Catalysxt/fir3fly/README.md

# fir3fly
This is an enlarged 4-digit 7-segment display. The motivation is to track my boxing sessions.

- [Interactive HTML BOM](https://Catalysxt.github.io/fir3fly/ibom_v2.html)
