Catalysxt/fir3fly/docs/7-seg display.png

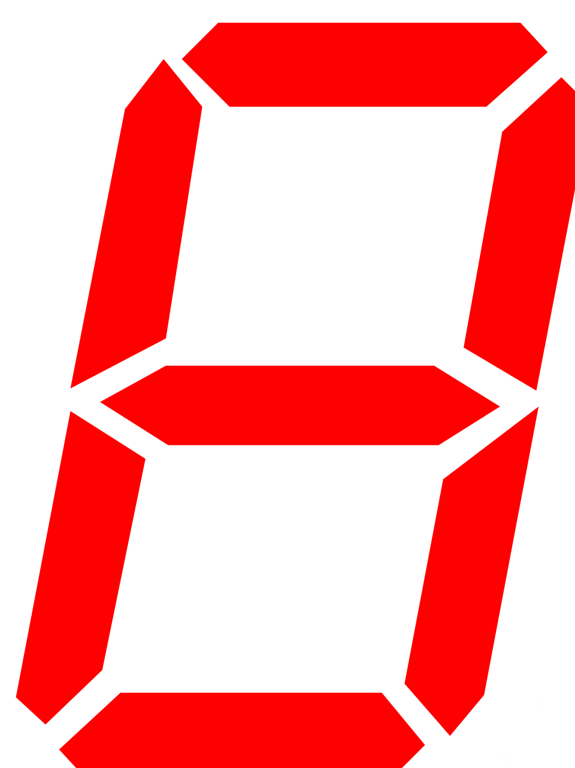
docs/7-seg display.png
