Catalysxt/fir3fly/fab/current/3d_img_1.png

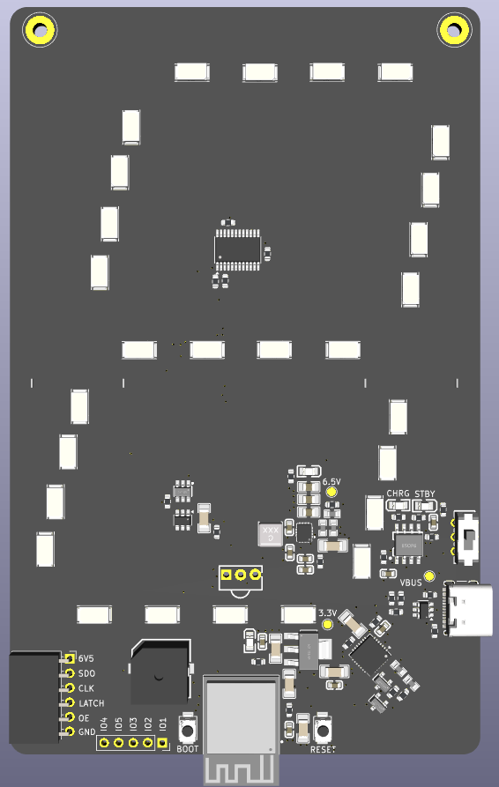
fab/current/3d_img_1.png
