Catalysxt/fir3fly/fab/current/3d_img_2.png

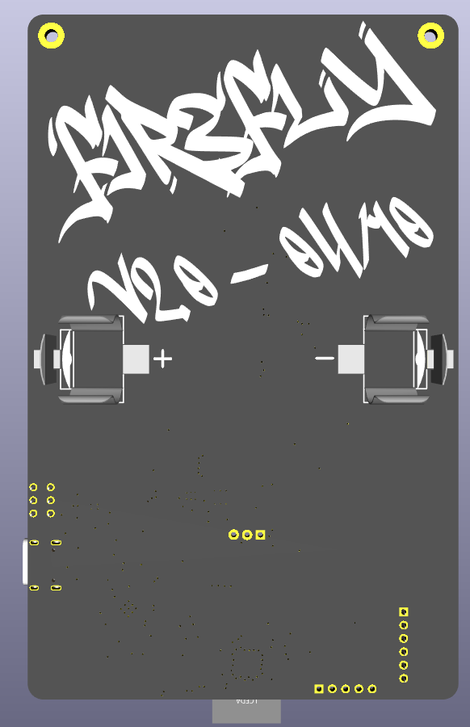
fab/current/3d_img_2.png
