Catalysxt/fir3fly/fab/current/fab_layer_plots_v2_images/B.Silk.png

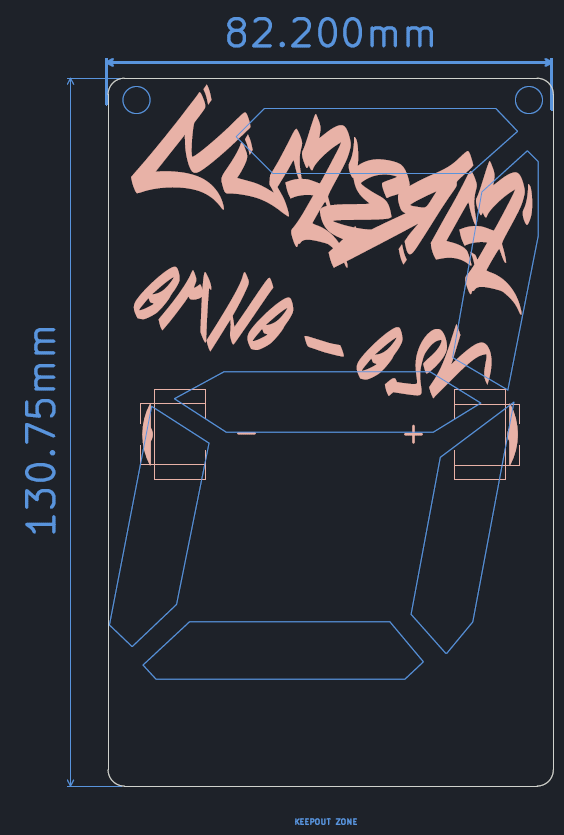
fab/current/fab_layer_plots_v2_images/B.Silk.png
