Catalysxt/fir3fly/fab/current/fab_layer_plots_v2_images/F.Cu.png

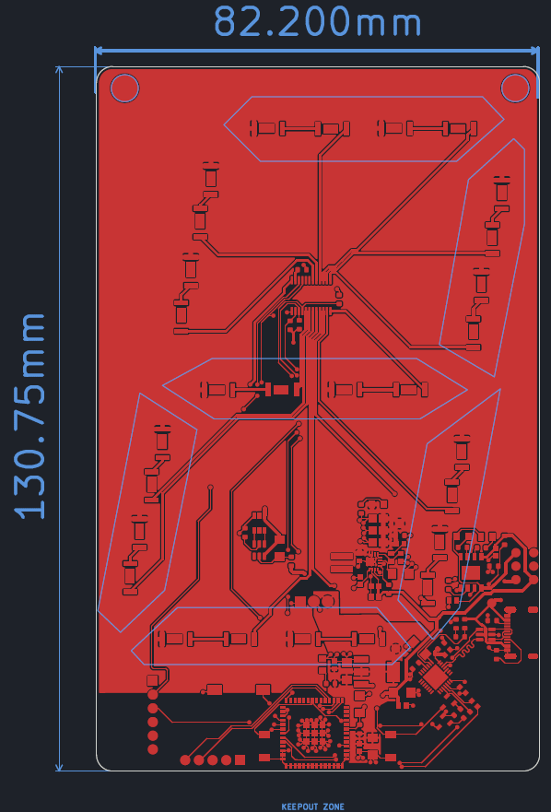
fab/current/fab_layer_plots_v2_images/F.Cu.png
