Catalysxt/fir3fly/fab/current/fab_layer_plots_v2_images/F.Silk.png

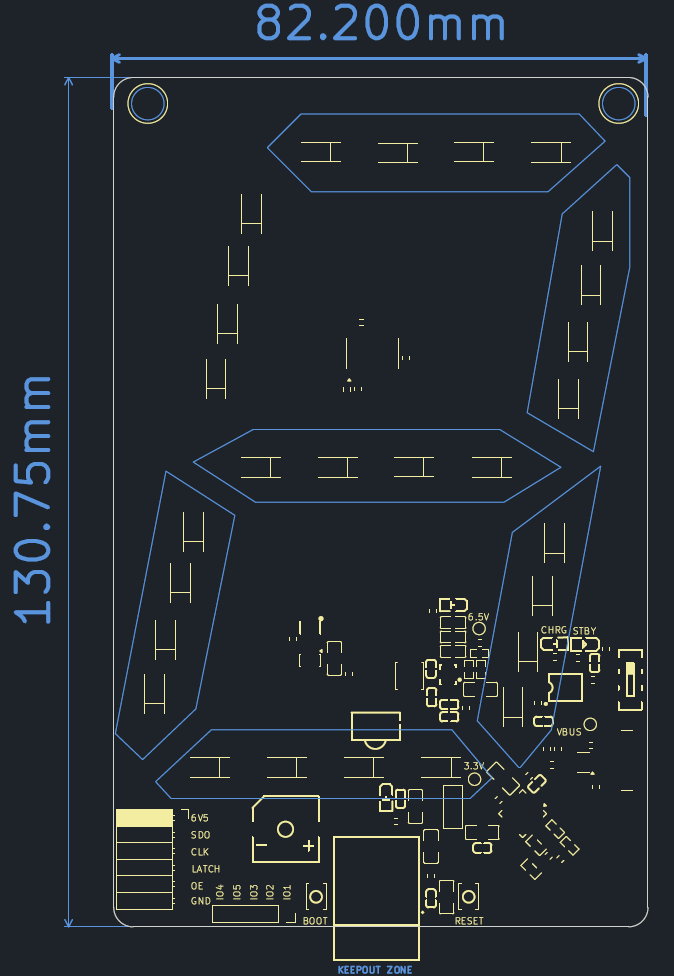
fab/current/fab_layer_plots_v2_images/F.Silk.png
