Catalysxt/fir3fly/fab/current/sch_v1_images/1.png

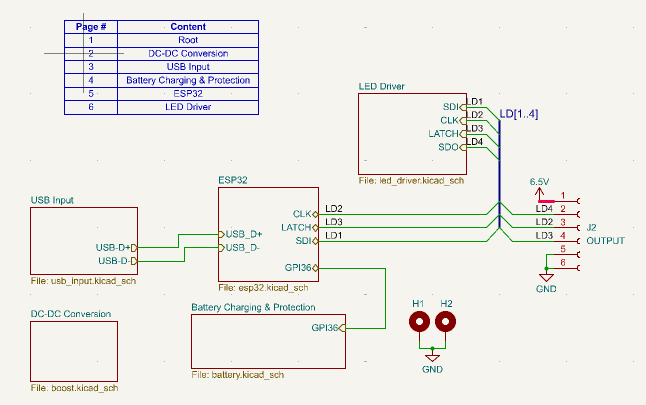
fab/current/sch_v1_images/1.png
