Catalysxt/fir3fly/fab/current/sch_v1_images/3.png

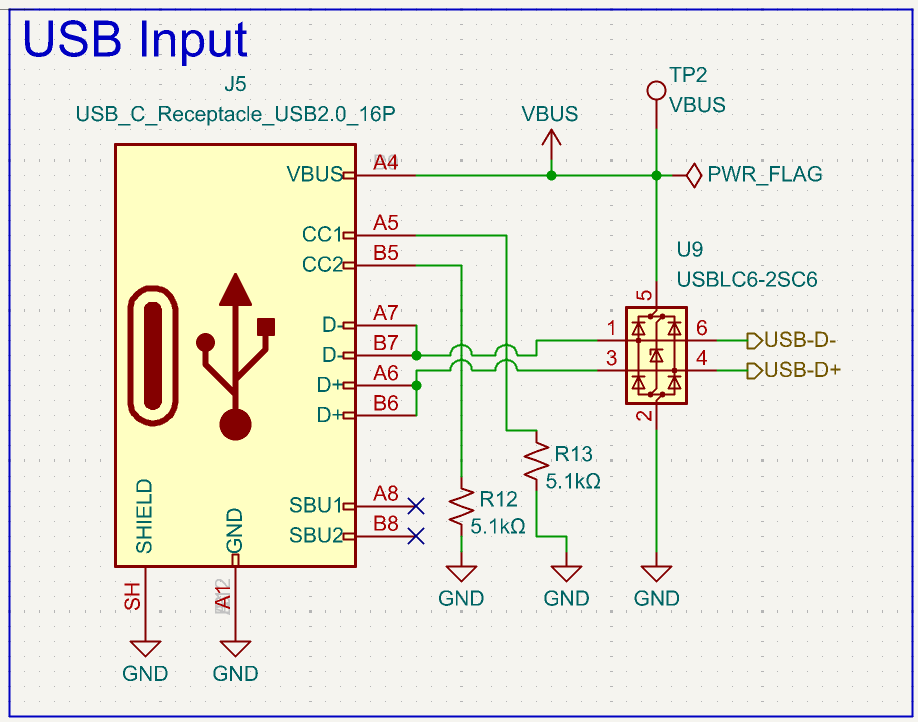
fab/current/sch_v1_images/3.png
