Catalysxt/fir3fly/fab/current/sch_v1_images/4.png

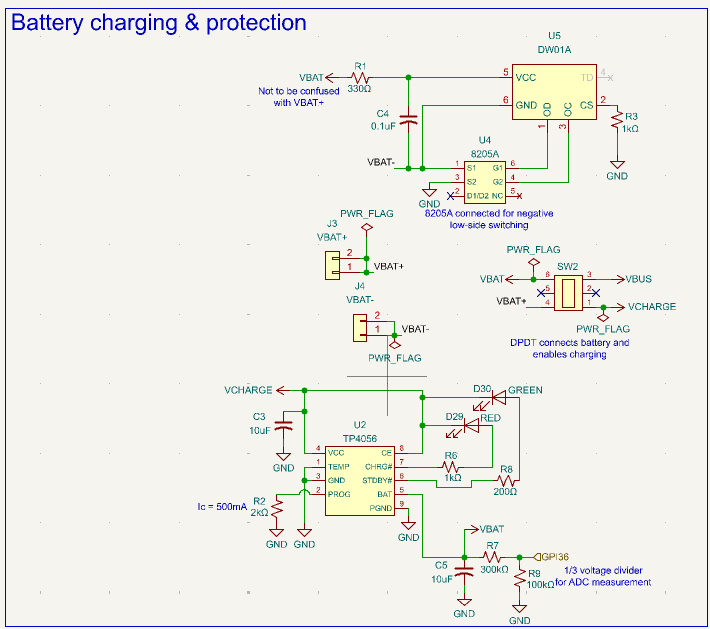
fab/current/sch_v1_images/4.png
