Catalysxt/fir3fly/fab/current/sch_v1_images/5.png

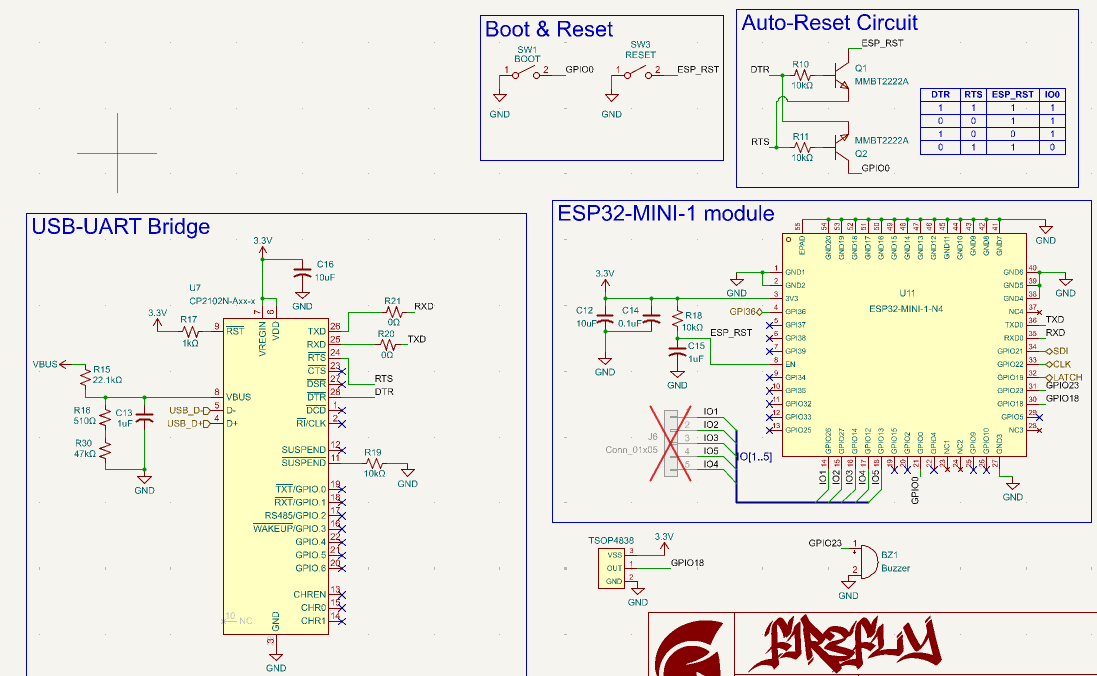
fab/current/sch_v1_images/5.png
