Catalysxt/fir3fly/fab/current/sch_v1_images/6.png

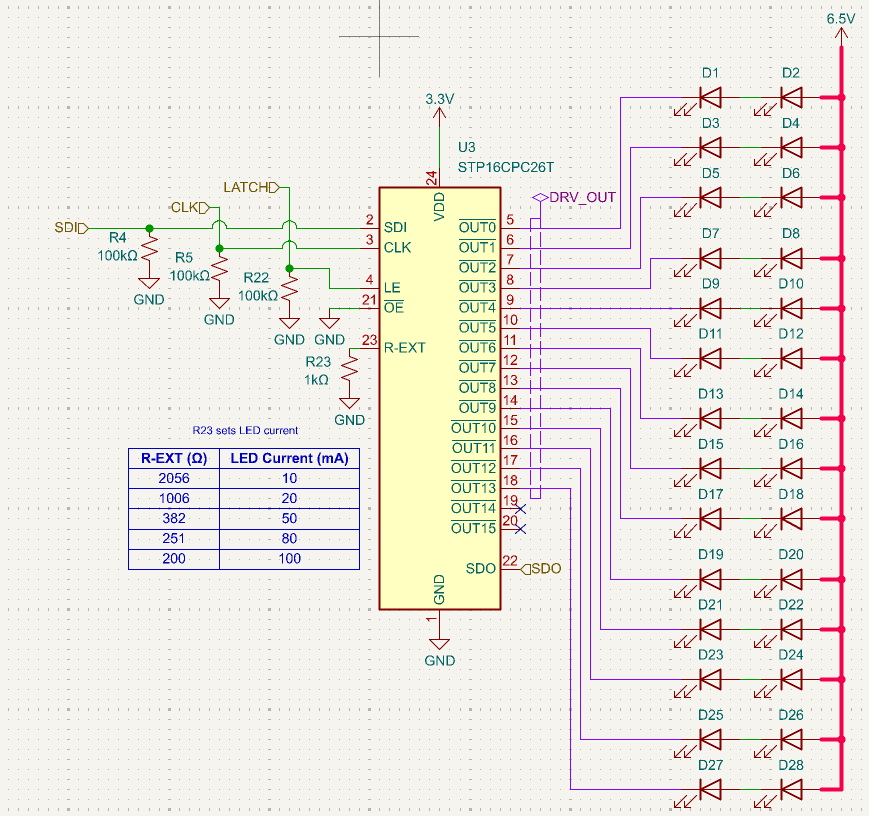
fab/current/sch_v1_images/6.png
