Catalysxt/fir3fly/docs/enclosure/3d_model.step

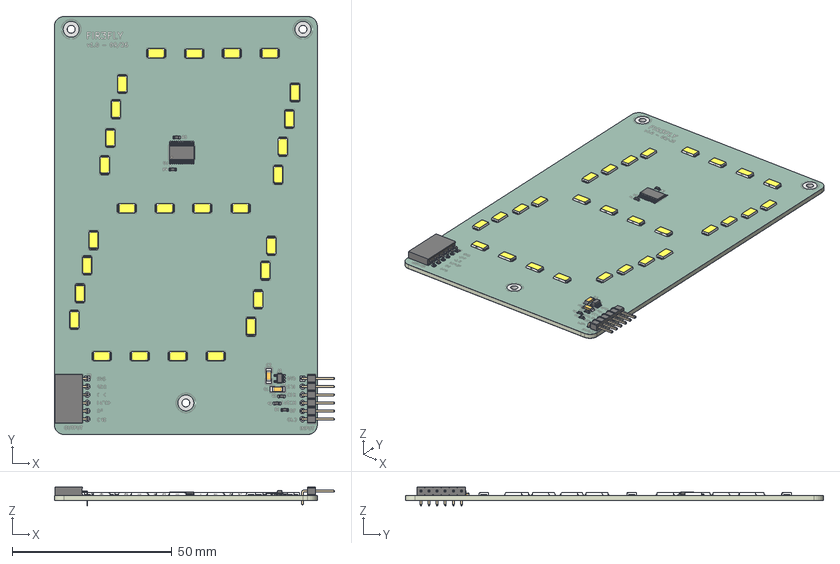
[picture p15: CAD file, 2026-10-04]
docs/enclosure/3d_model.step
87.7 x 130.8 x 5.84 mm
R_0603_1608Metric x 5
C1206_L3.2-W1.6-H1.3 x 2
LED-SMD_3P-L5.7-W3.0-H0.8 x 28
SOT-23-5
PinHeader_1x06_P254mm_Horizontal
PinSocket_1x06_P2.54mm_Horizontal
TSSOP-24_4.4x7.8mm_P0.65mm
fir3fly_one_side_copper
fir3fly_one_side_pad
fir3fly_one_side_via
fir3fly_one_side_silkscreen
fir3fly_one_side_soldermask x 2
fir3fly_one_side_PCB
