Catalysxt/fir3fly/docs/enclosure/Enclosure_Base.stl

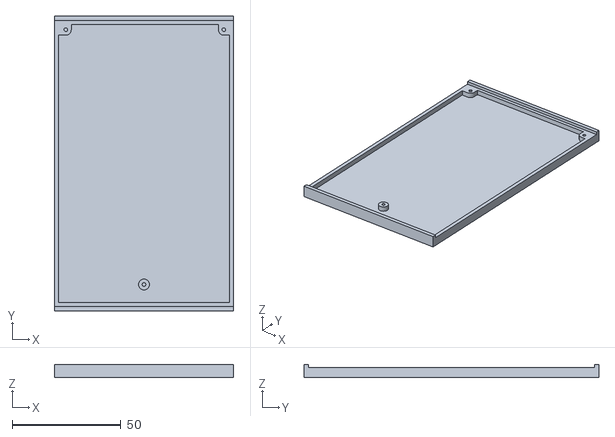
[picture p16: CAD file, 2026-10-04]
docs/enclosure/Enclosure_Base.stl
82.2 x 135.3 x 6.00
