Catalysxt/fir3fly/docs/enclosure/Enclosure_Lid.stl

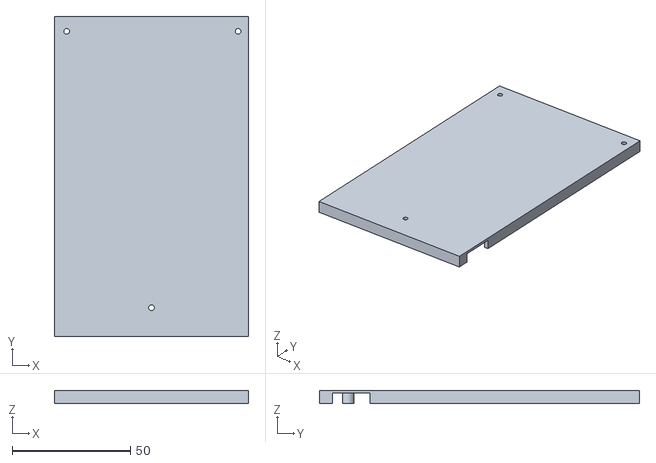
[picture p17: CAD file, 2026-10-04]
docs/enclosure/Enclosure_Lid.stl
82.2 x 135.3 x 5.70
