Catalysxt/fir3fly/docs/enclosure/enclosure.FCStd

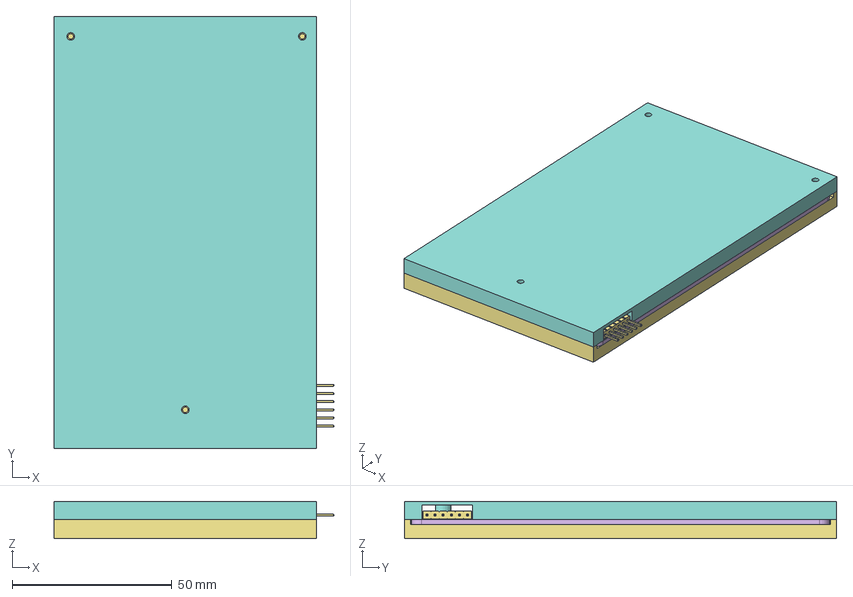
[picture p18: CAD file, 2026-10-04]
docs/enclosure/enclosure.FCStd
87.7 x 135.4 x 11.7 mm
R_0603_1608Metric
C1206_L3.2-W1.6-H1.3
LED-SMD_3P-L5.7-W3.0-H0.8
LED-SMD_3P-L5.7-W3.0-H0.009
LED-SMD_3P-L5.7-W3.0-H0.010
LED-SMD_3P-L5.7-W3.0-H0.011
C1206_L3.2-W1.6-H1.004
SOT-23-5
R_0603_1608Metric002
LED-SMD_3P-L5.7-W3.0-H0.012
LED-SMD_3P-L5.7-W3.0-H0.013
LED-SMD_3P-L5.7-W3.0-H0.014
LED-SMD_3P-L5.7-W3.0-H0.015
R_0603_1608Metric004
PinHeader_1x06_P254mm_Horizontal
LED-SMD_3P-L5.7-W3.0-H0.016
LED-SMD_3P-L5.7-W3.0-H0.017
LED-SMD_3P-L5.7-W3.0-H0.018
LED-SMD_3P-L5.7-W3.0-H0.019
PinSocket_1x06_P2.54mm_Horizontal
LED-SMD_3P-L5.7-W3.0-H0.020
R_0603_1608Metric006
LED-SMD_3P-L5.7-W3.0-H0.021
LED-SMD_3P-L5.7-W3.0-H0.022
LED-SMD_3P-L5.7-W3.0-H0.023
LED-SMD_3P-L5.7-W3.0-H0.024
LED-SMD_3P-L5.7-W3.0-H0.025
LED-SMD_3P-L5.7-W3.0-H0.026
LED-SMD_3P-L5.7-W3.0-H0.027
LED-SMD_3P-L5.7-W3.0-H0.028
LED-SMD_3P-L5.7-W3.0-H0.029
TSSOP-24_4.4x7.8mm_P0.65mm
LED-SMD_3P-L5.7-W3.0-H0.030
LED-SMD_3P-L5.7-W3.0-H0.031
LED-SMD_3P-L5.7-W3.0-H0.032
R_0603_1608Metric008
LED-SMD_3P-L5.7-W3.0-H0.033
LED-SMD_3P-L5.7-W3.0-H0.034
LED-SMD_3P-L5.7-W3.0-H0.035
fir3fly_one_side_copper
fir3fly_one_side_pad
fir3fly_one_side_via
fir3fly_one_side_silkscreen
fir3fly_one_side_soldermask
fir3fly_one_side_soldermask001
fir3fly_one_side_PCB
Enclosure_Base
Enclosure_Lid
