Catalysxt/fir3fly/docs/schematic_v2.pdf

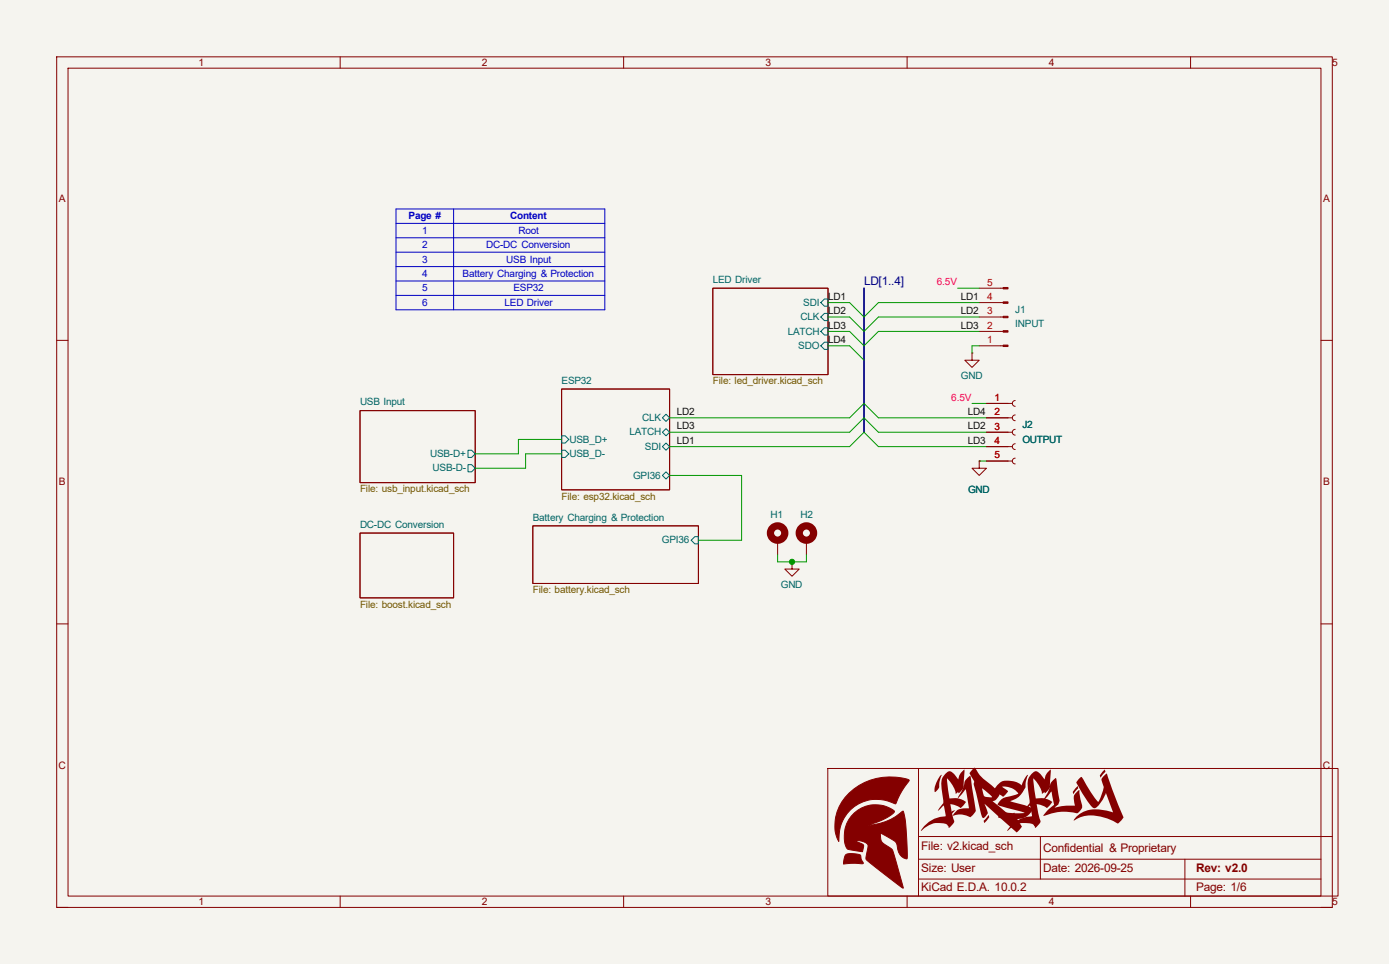
[picture p19: page 1]

3 | Battery Charging & Protection USB Input 4

5 | ESP32

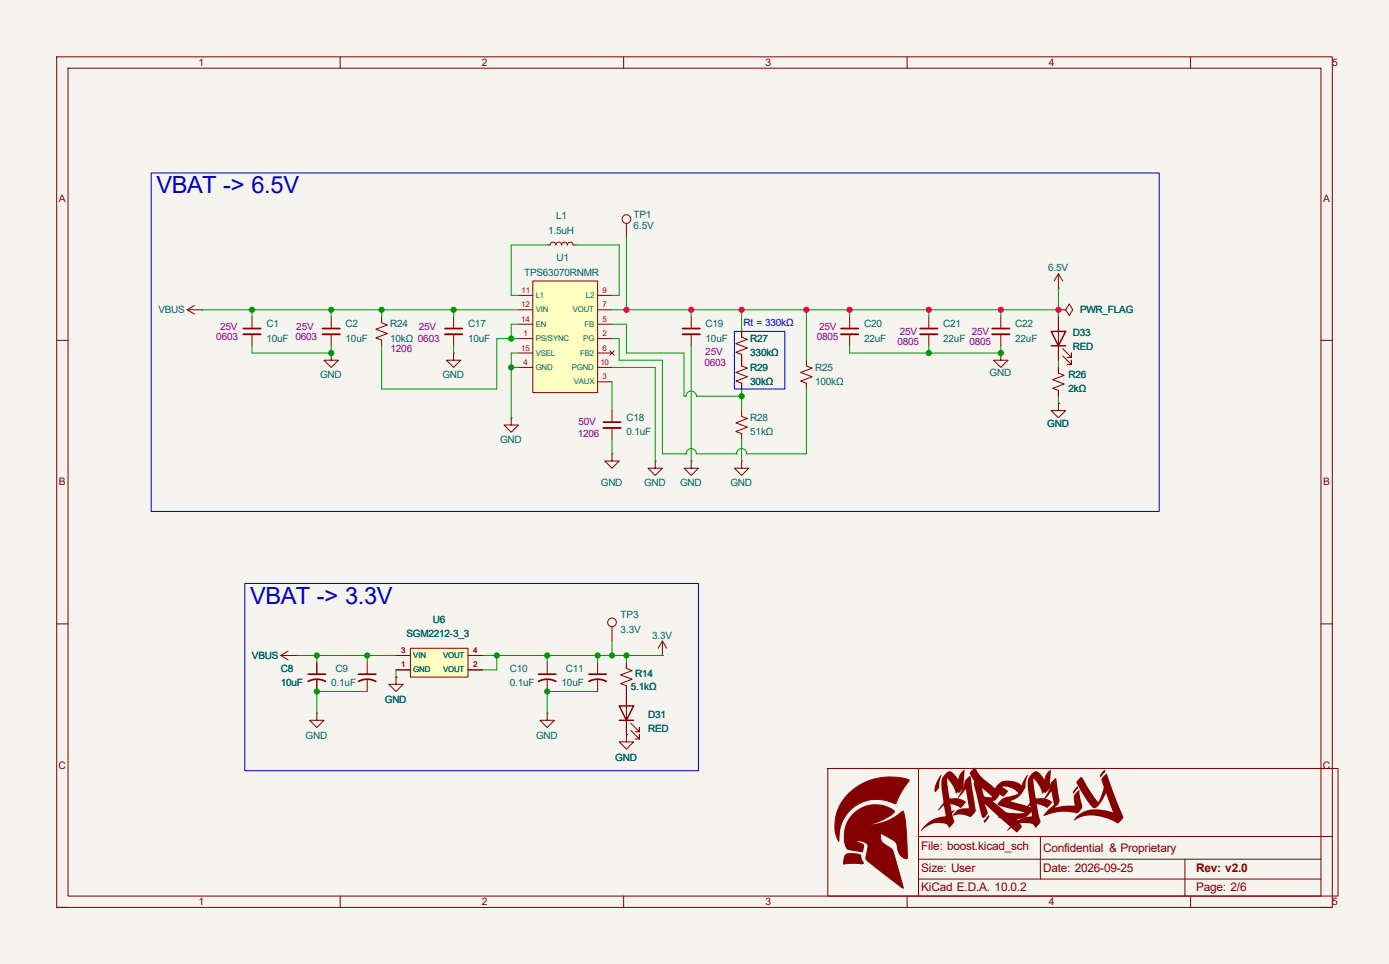
[picture p20: page 2]

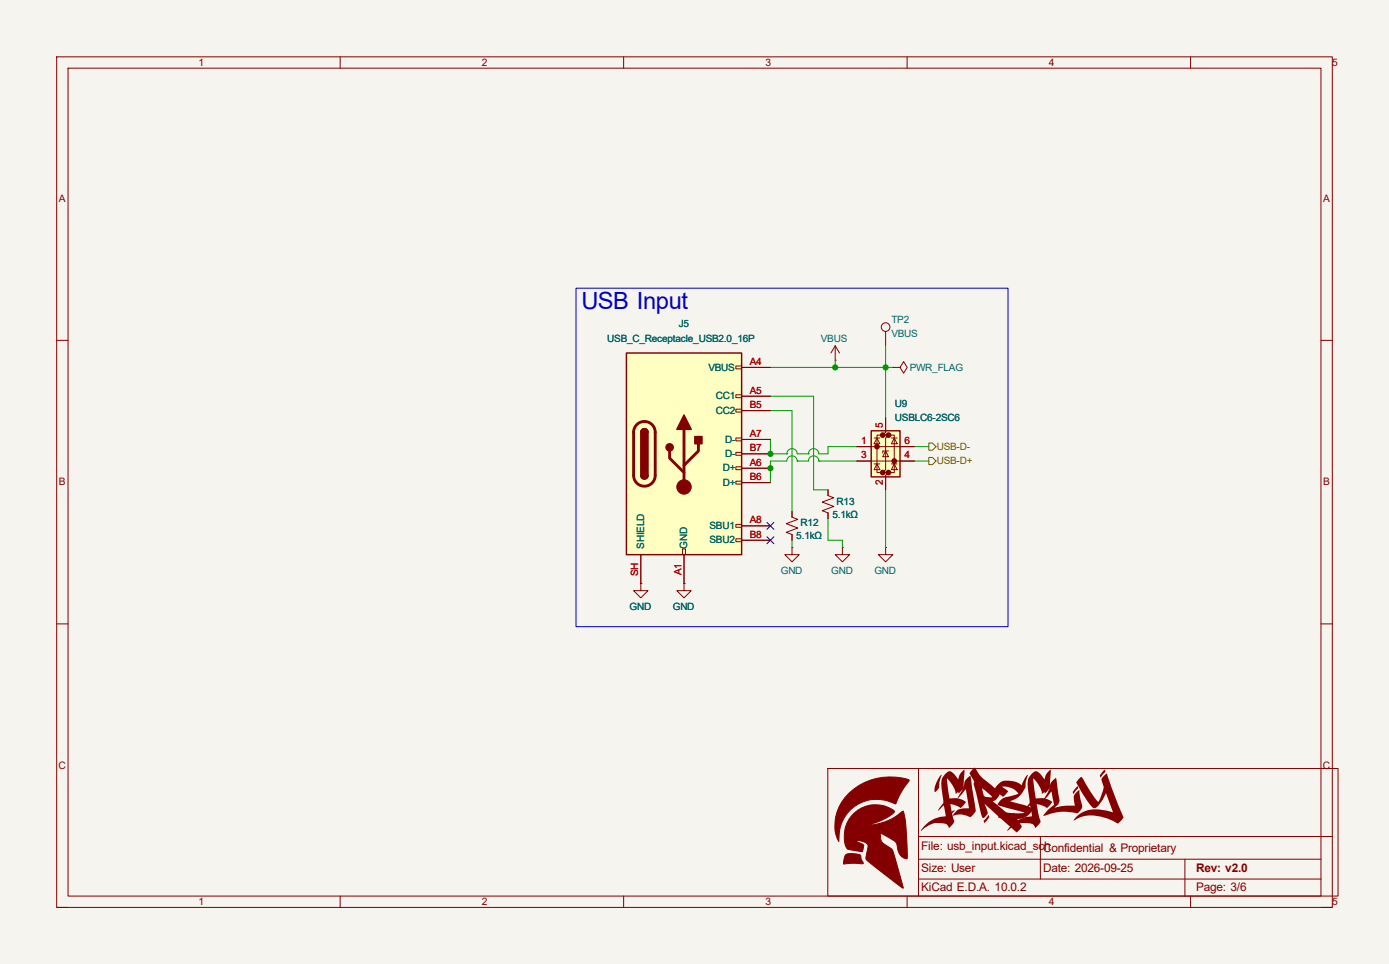
[picture p21: page 3]

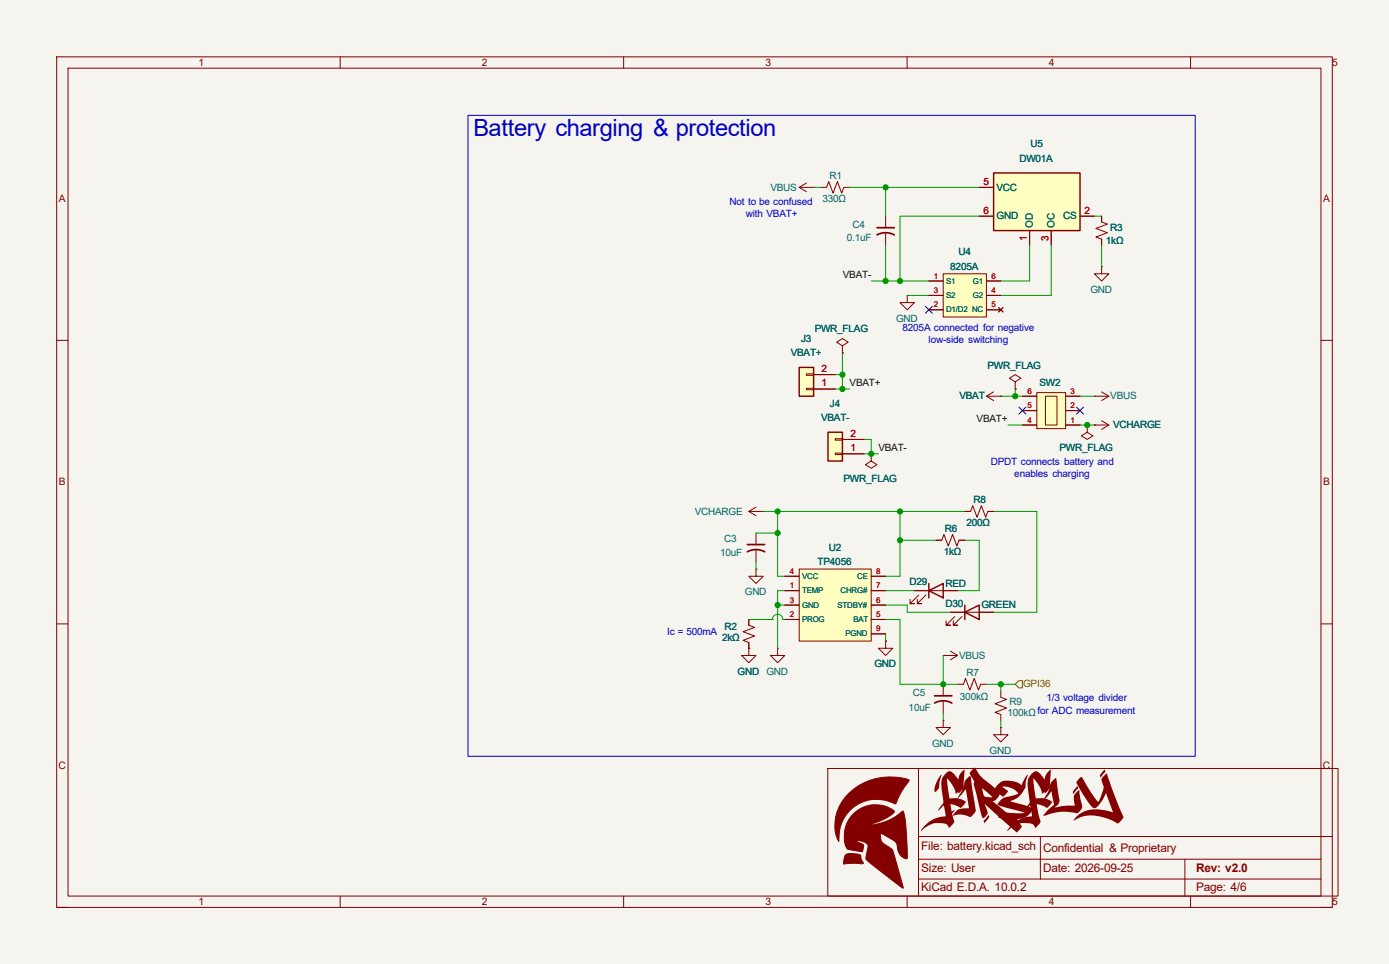
[picture p22: page 4]

VBUS GPI36 VBAT+ VBAT- VBAT- VBAT+ Battery charging & protection
VBATR8

PWR_FLAG 12
low-side switching VBAT PWR_FLAG

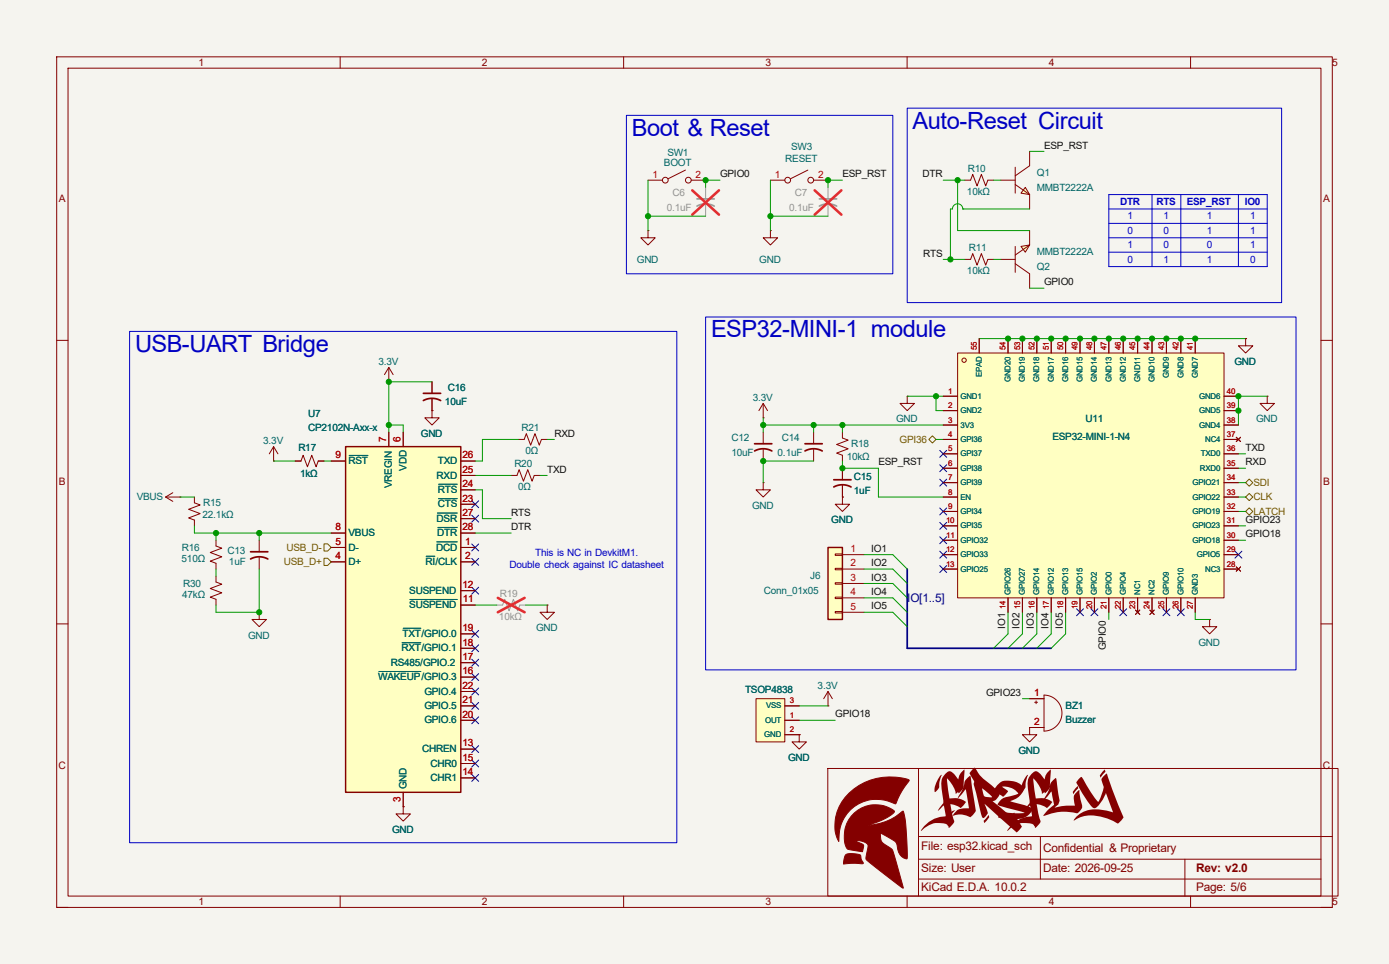
[picture p23: page 5]

Auto-Reset Circuit

ESP32-MINI-1 module USB-UART Bridge

7 VBUS 8 RST 9 SUSPEND 11 SUSPEND 12 CHREN 13 CHR1 14 CHR0 15 WAKEUP/GPIO.3 16 RS485/GPIO.2 17 RXT/GPIO.1 18 TXT/GPIO.0 19 GPIO.6 20 GPIO.5 21 GPIO.4 22 CTS 23 RTS 24 RXD 25 TXD 26 DSR 27 DTR 28 U7CP2102N-Axx-x R19

7 VBUS 8 RST 9 SUSPEND 11 SUSPEND 12 CHREN 13 CHR1 14 CHR0 15 WAKEUP/GPIO.3 16 RS485/GPIO.2 17 RXT/GPIO.1 18 TXT/GPIO.0 19 GPIO.6 20 GPIO.5 21 GPIO.4 22 CTS 23 RTS 24 RXD 25 TXD 26 DSR 27 DTR 28 GND

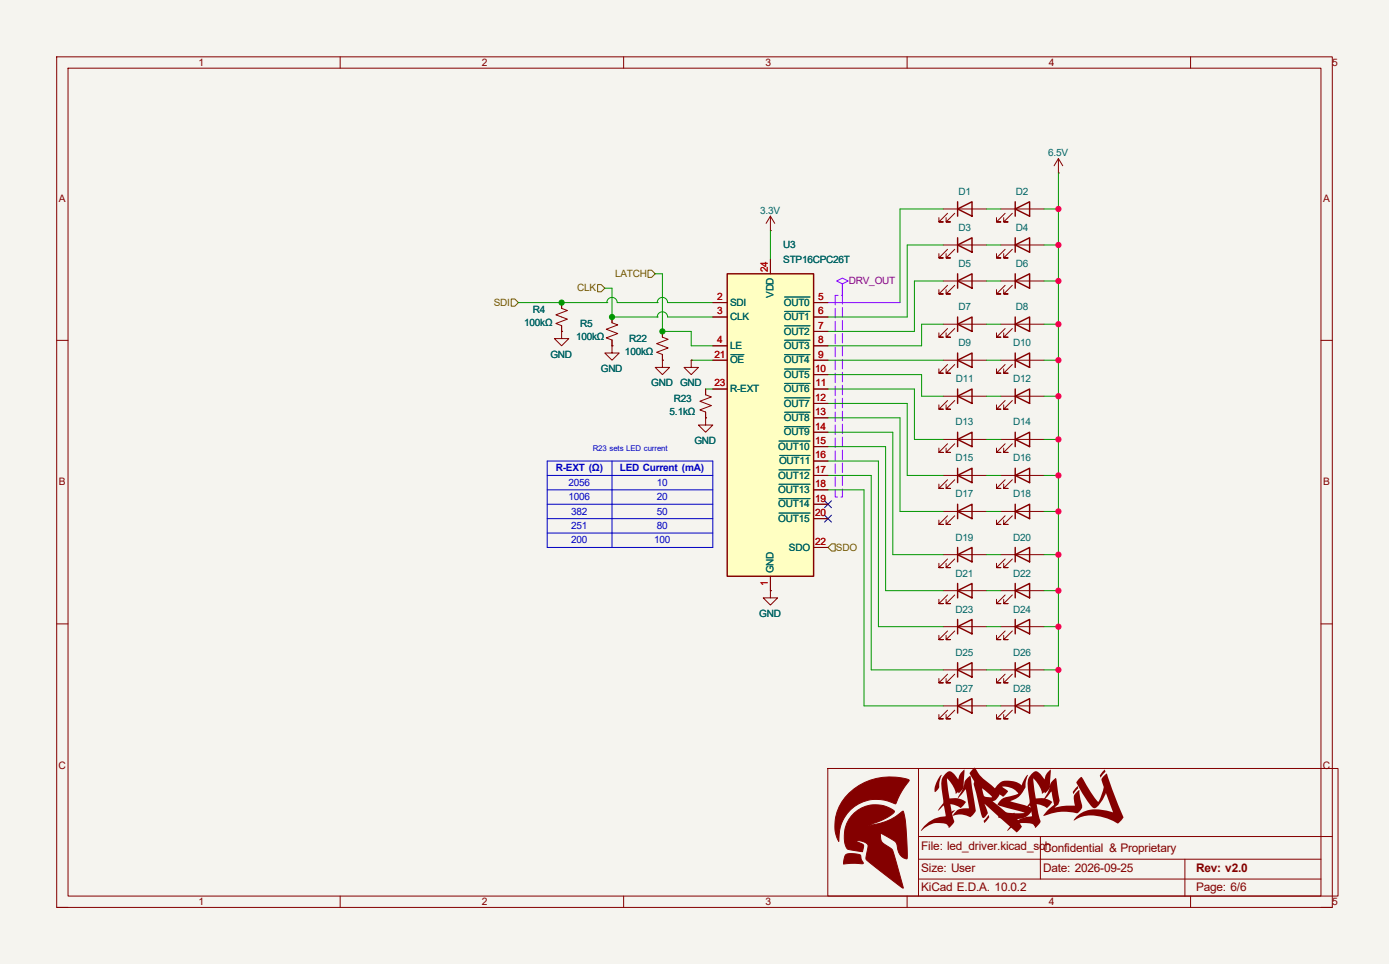
[picture p24: page 6]

R-EXT (Ω) | LED Current (mA) 2056 10

1006 | 20
382 | 50
251 | 80
