Catalysxt/fir3fly/fab/current/fabrication_layer_plots_v2.pdf

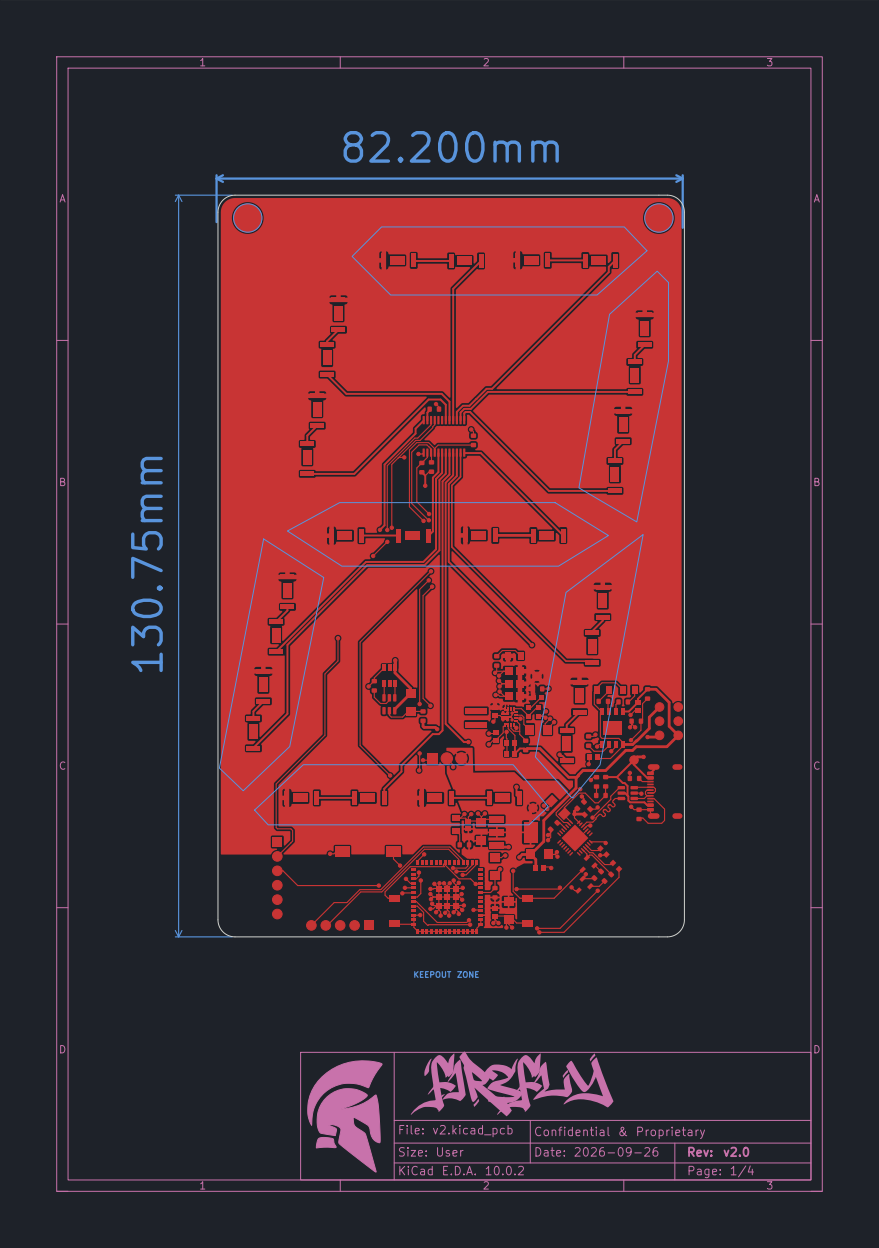
[picture p25: page 1]

FIR3FLY | D Date: 2026-09-26

File: v2.kicad_pcb | Confidential & Proprietary
Size: User | | Rev: v2.0
KiCad E.D.A. 10.0.2

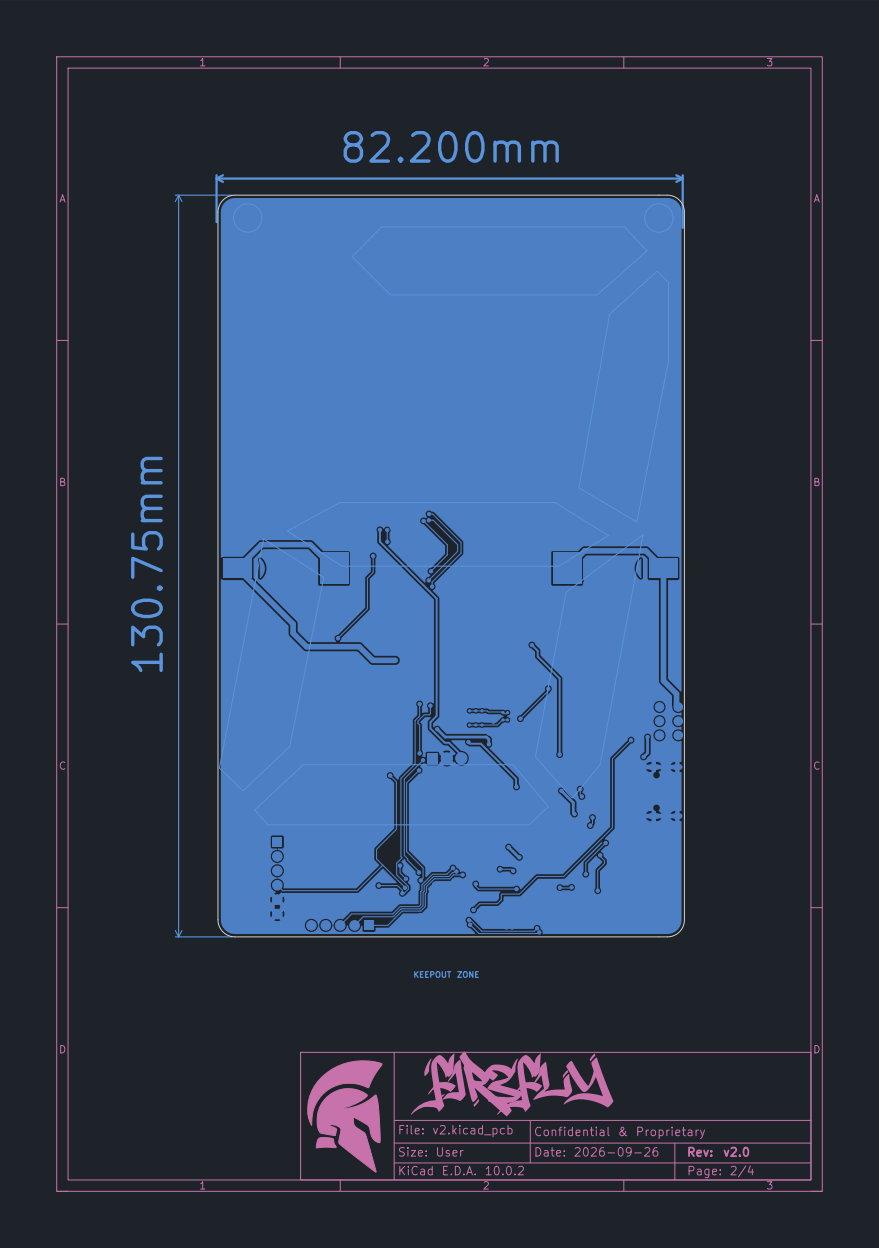
[picture p26: page 2]

FIR3FLY | D Date: 2026-09-26

File: v2.kicad_pcb | Confidential & Proprietary

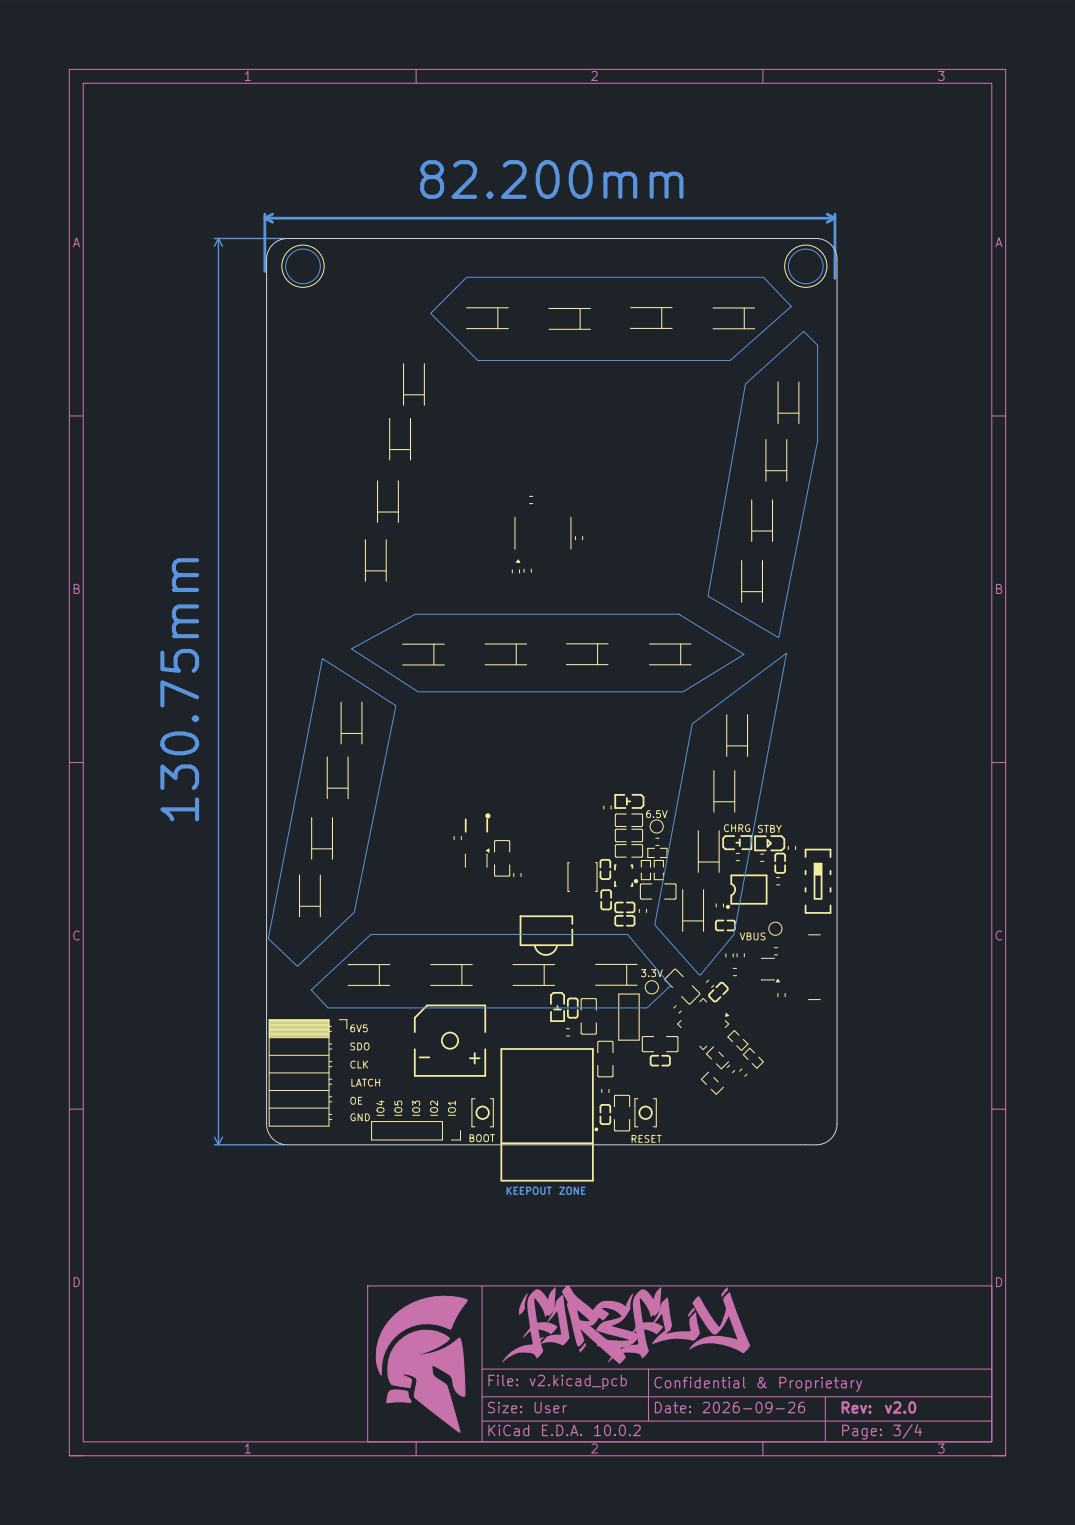
[picture p27: page 3]

FIR3FLY | D Date: 2026-09-26

File: v2.kicad_pcb | Confidential & Proprietary

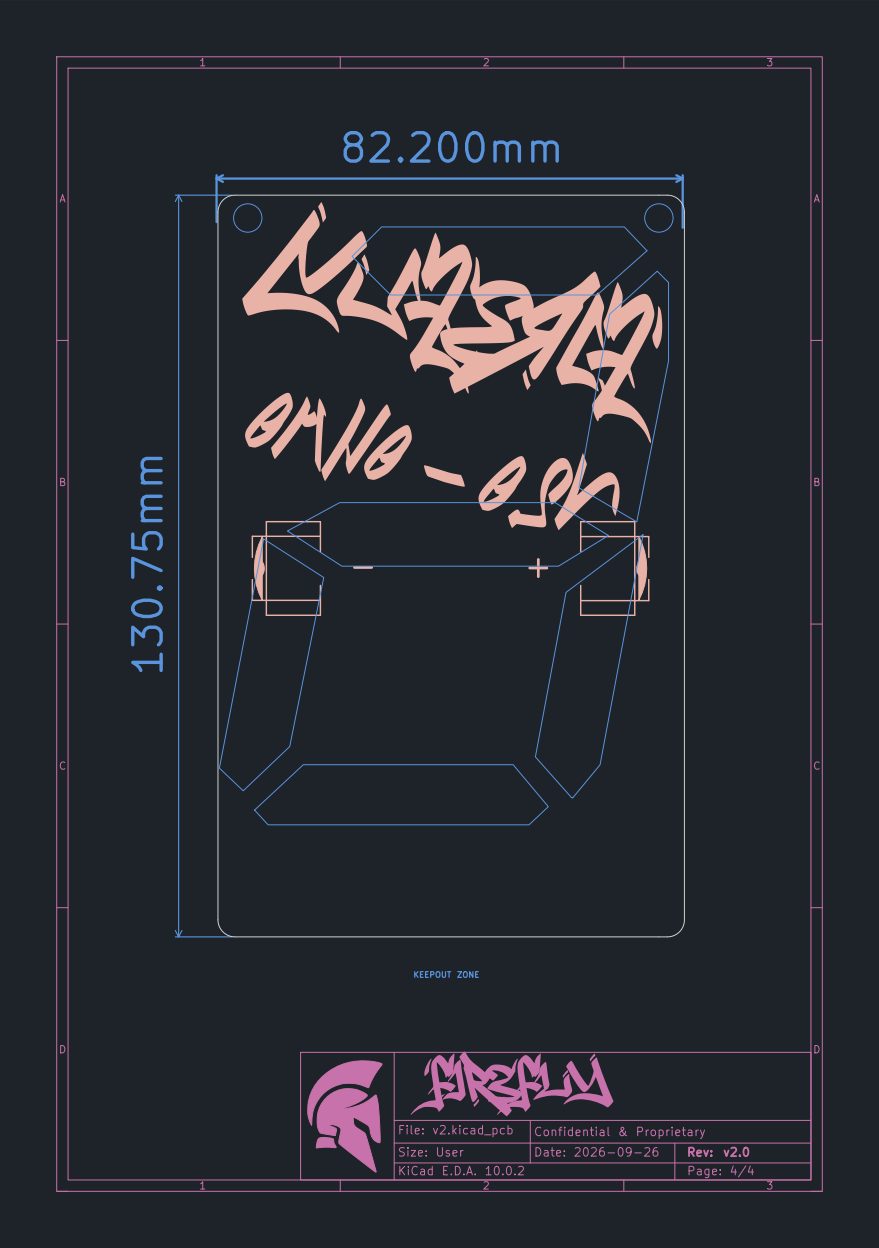
[picture p28: page 4]

FIR3FLY | D Date: 2026-09-26

File: v2.kicad_pcb | Confidential & Proprietary
