Catalysxt/fir3fly/fab/current/schematic_v2.pdf

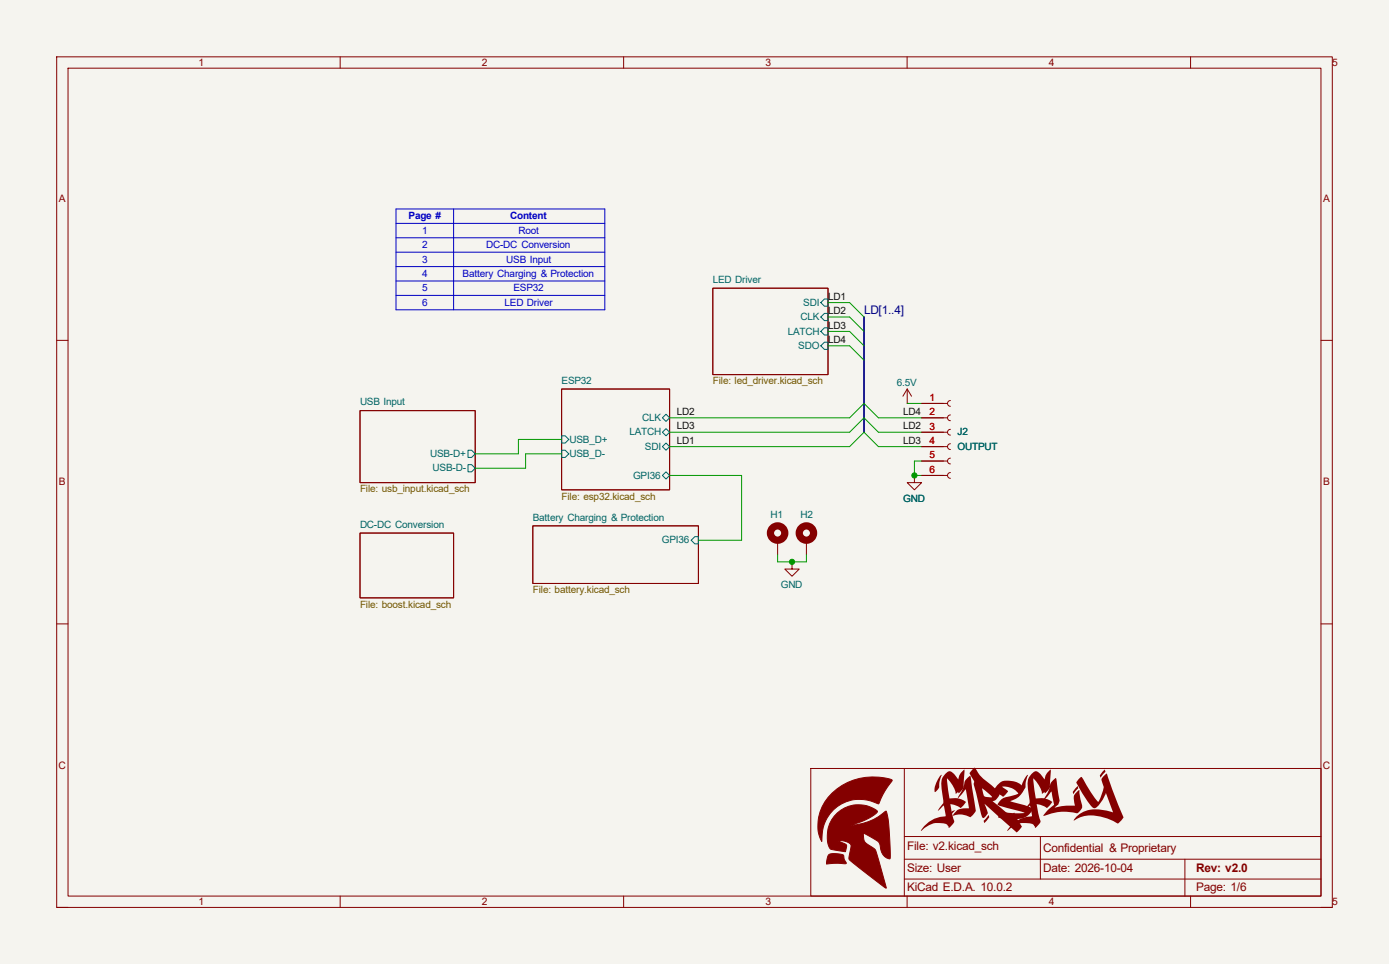
[picture p29: page 1]

LED Driver File: led_driver.kicad_sch GND

3 | Battery Charging & Protection USB Input 4

5 | ESP32

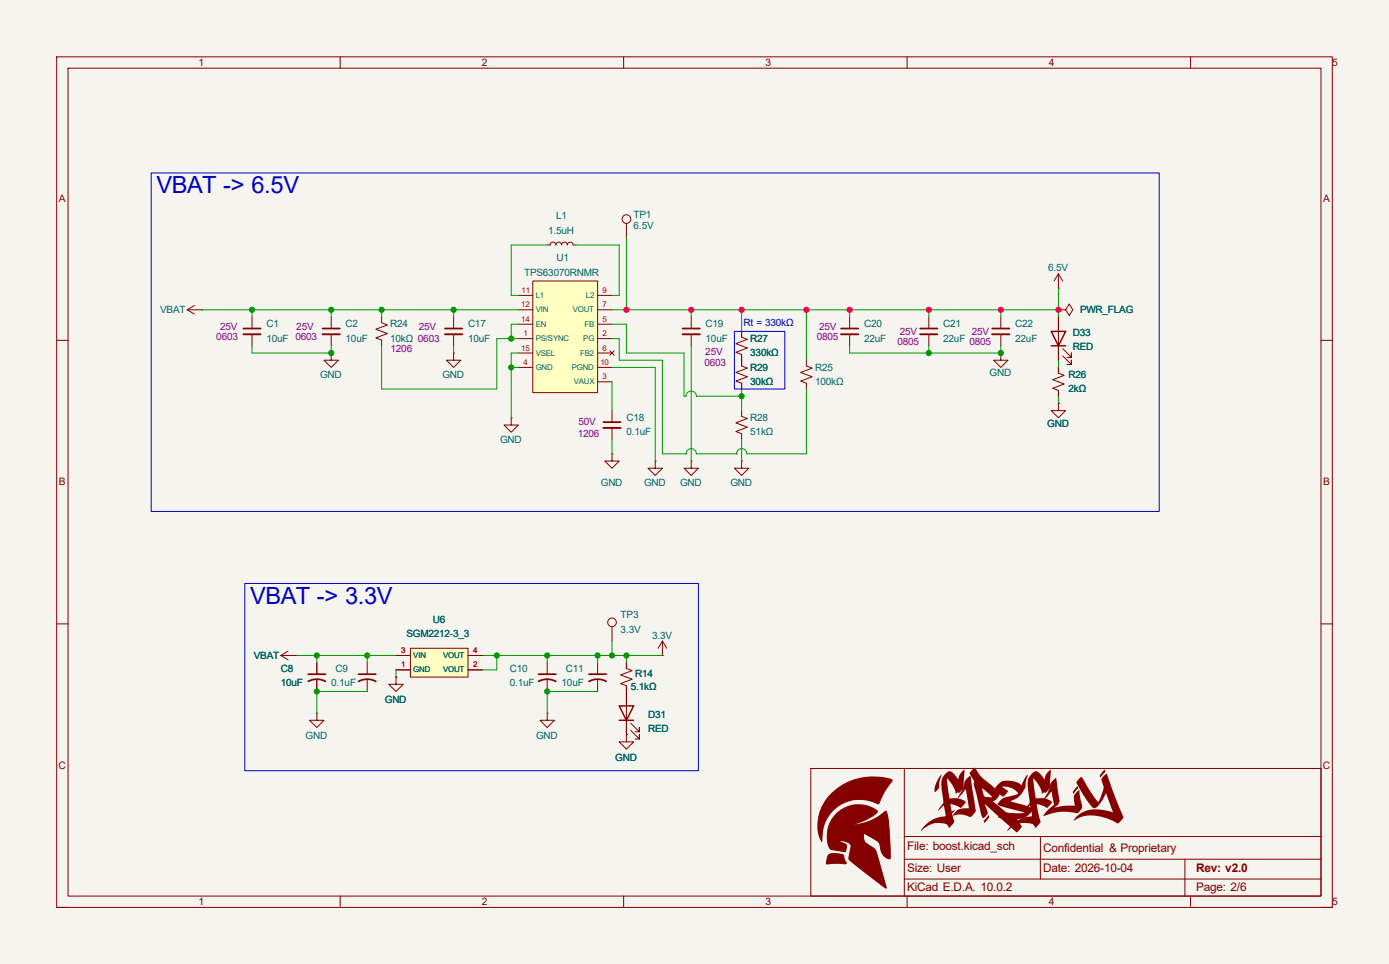
[picture p30: page 2]

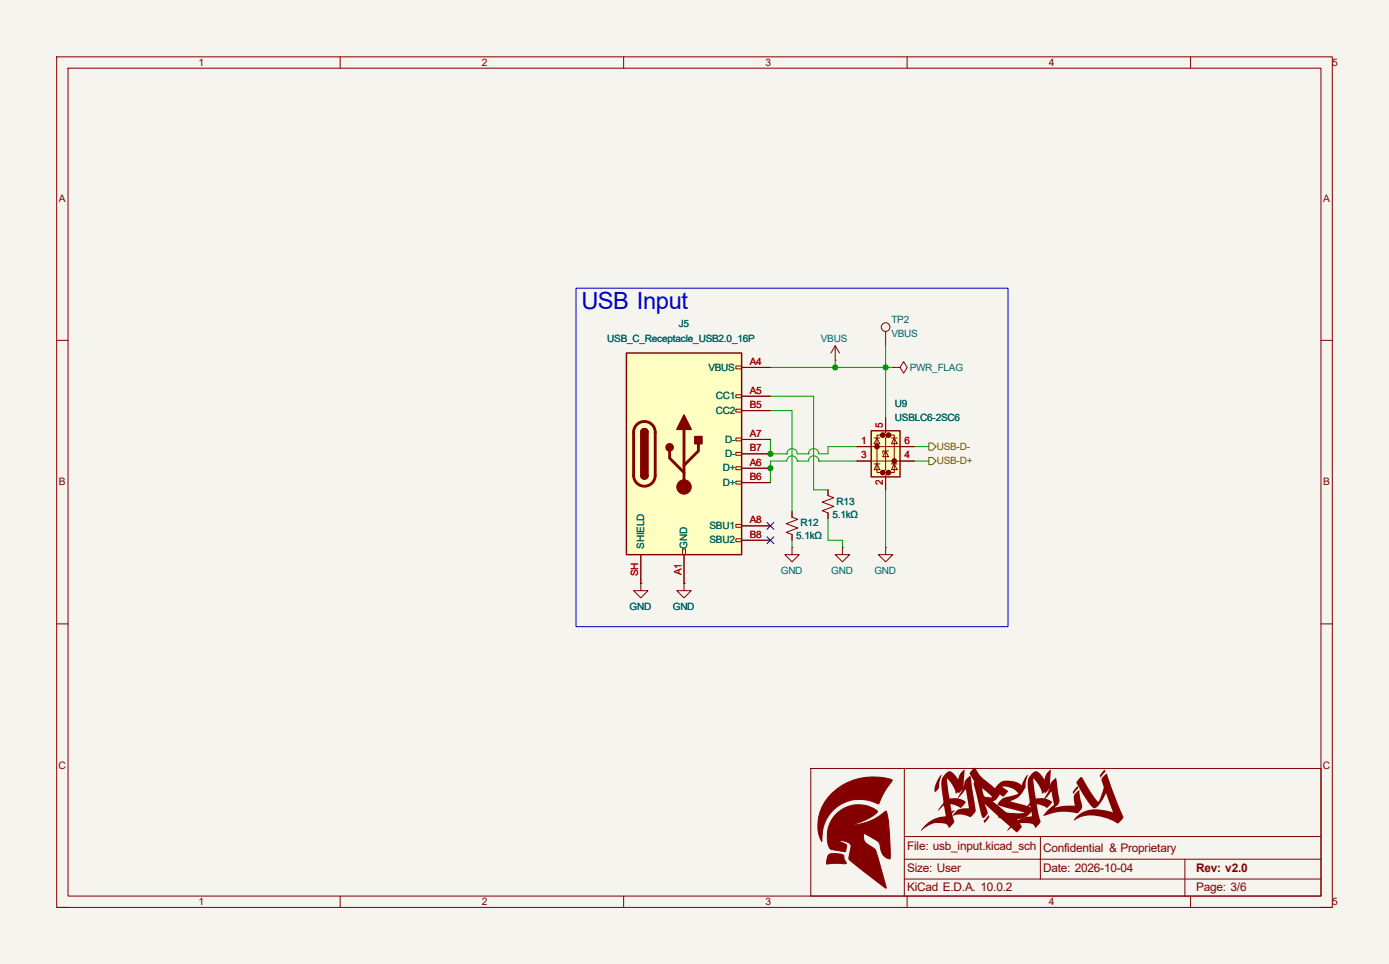
[picture p31: page 3]

USB-D+ USB-D- USB Input

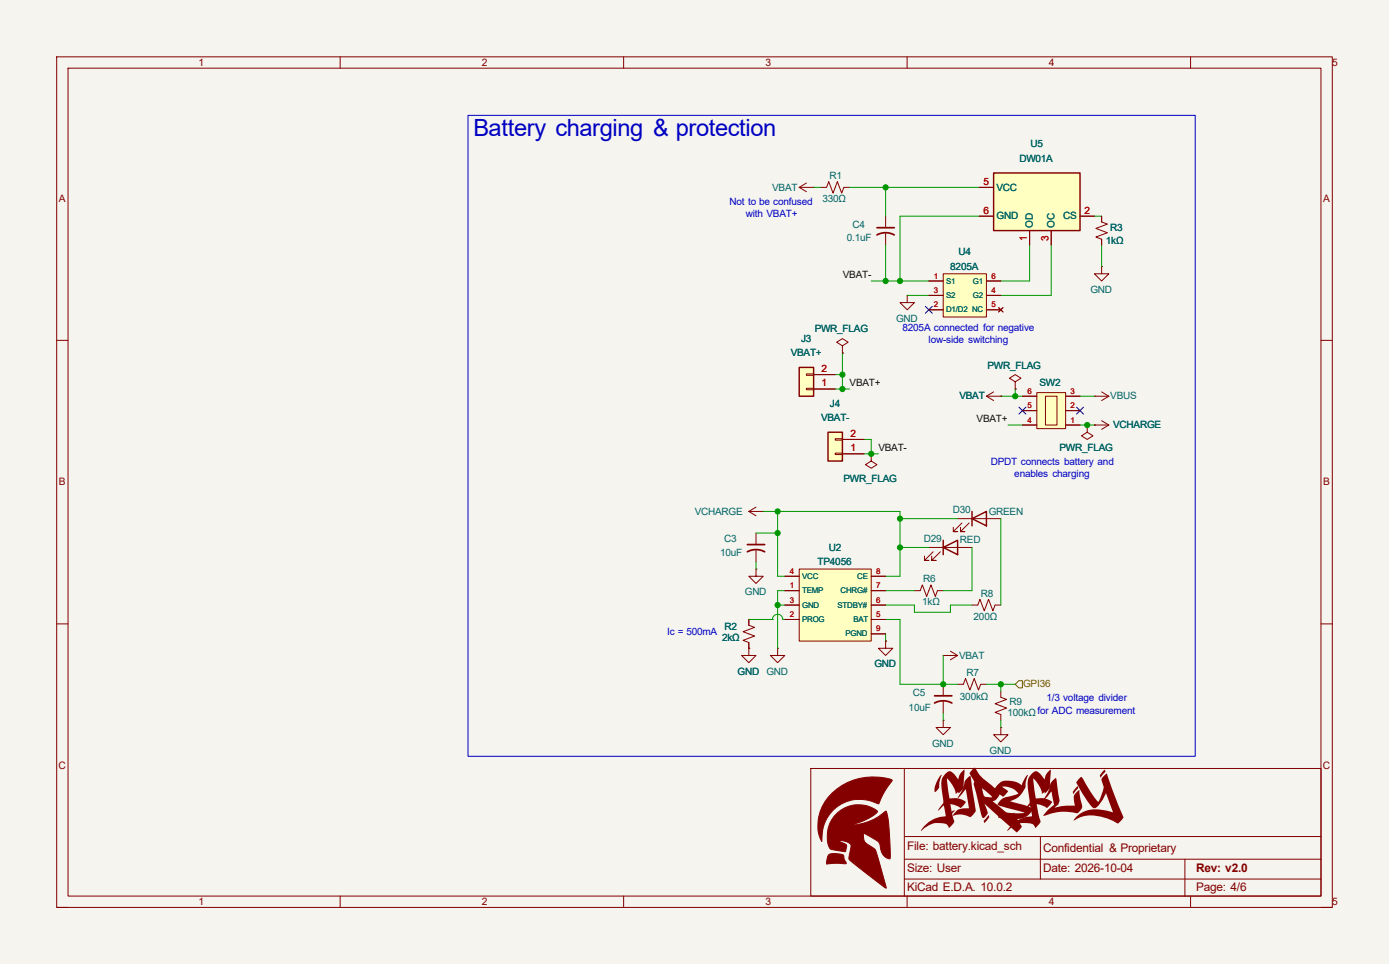
[picture p32: page 4]

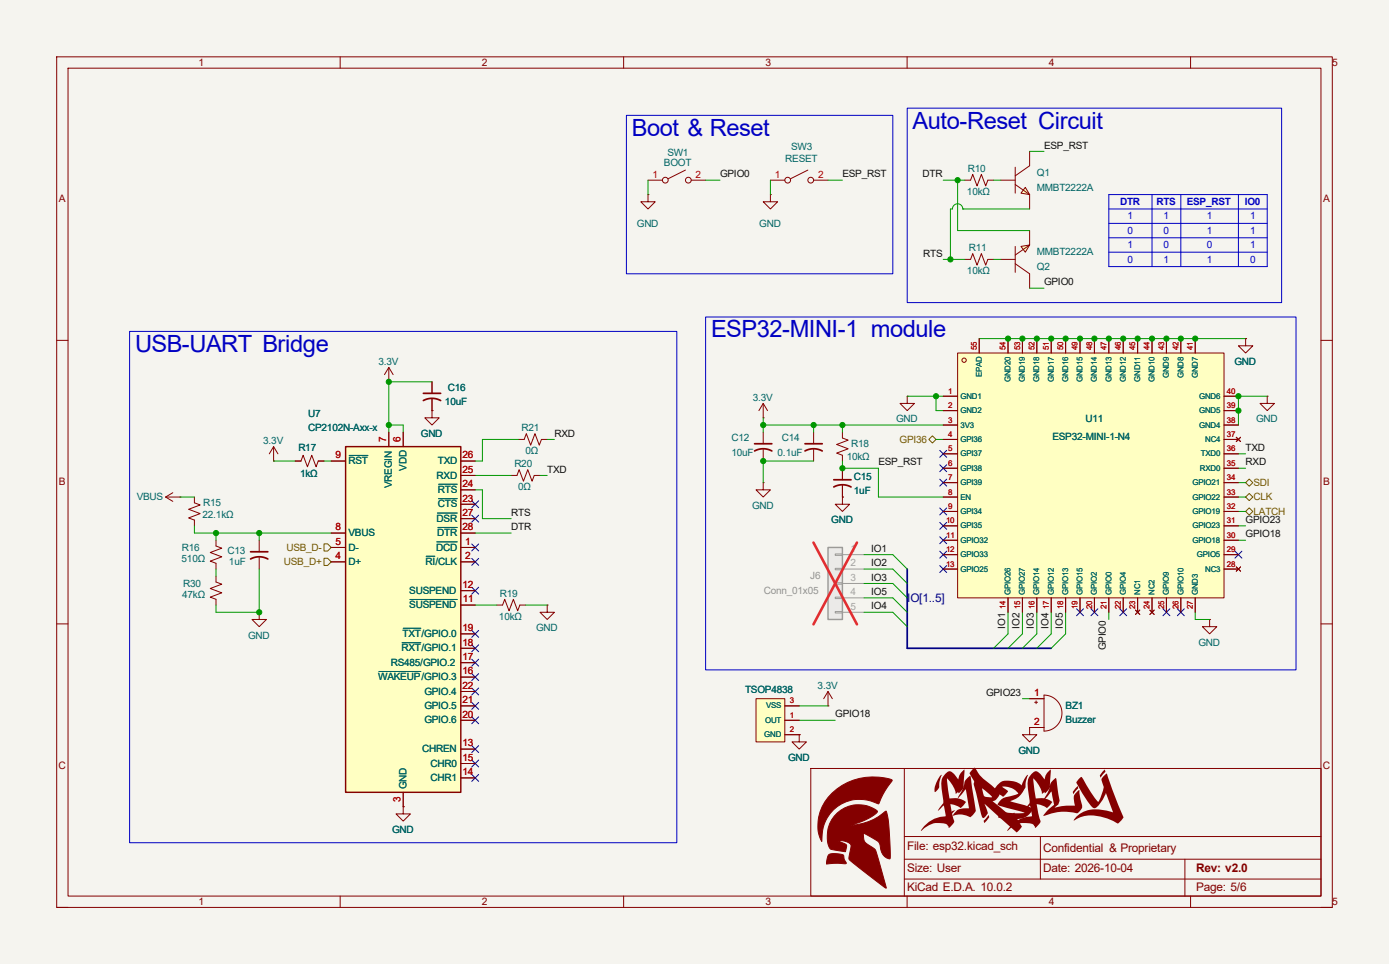
[picture p33: page 5]

DTR | RTS | ESP_RST | IO0

7 VBUS 8 RST 9 SUSPEND 11 SUSPEND 12 CHREN 13 CHR1 14 CHR0 15 WAKEUP/GPIO.3 16 RS485/GPIO.2 17 RXT/GPIO.1 18 TXT/GPIO.0 19 GPIO.6 20 GPIO.5 21 GPIO.4 22 CTS 23 RTS 24 RXD 25 TXD 26 DSR 27 DTR 28 U7CP2102N-Axx-x R18

7 VBUS 8 RST 9 SUSPEND 11 SUSPEND 12 CHREN 13 CHR1 14 CHR0 15 WAKEUP/GPIO.3 16 RS485/GPIO.2 17 RXT/GPIO.1 18 TXT/GPIO.0 19 GPIO.6 20 GPIO.5 21 GPIO.4 22 CTS 23 RTS 24 RXD 25 TXD 26 DSR 27 DTR 28 R17

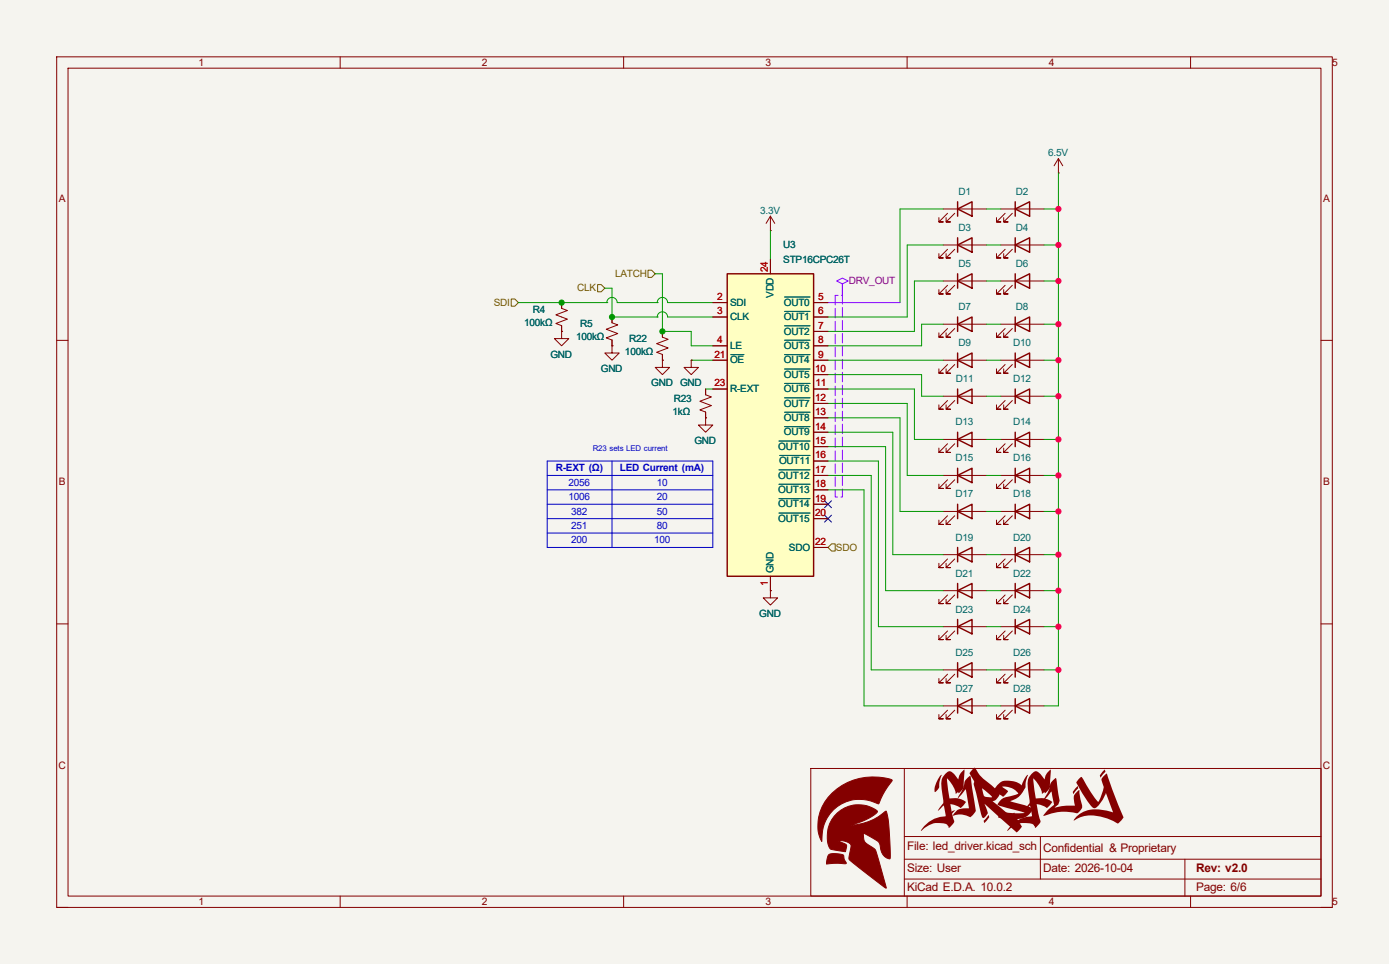
[picture p34: page 6]

1006 | 20
382 | 50
251 | 80
