Catalysxt/fir3fly/fab/archive/v1/fabrication layer plots.pdf

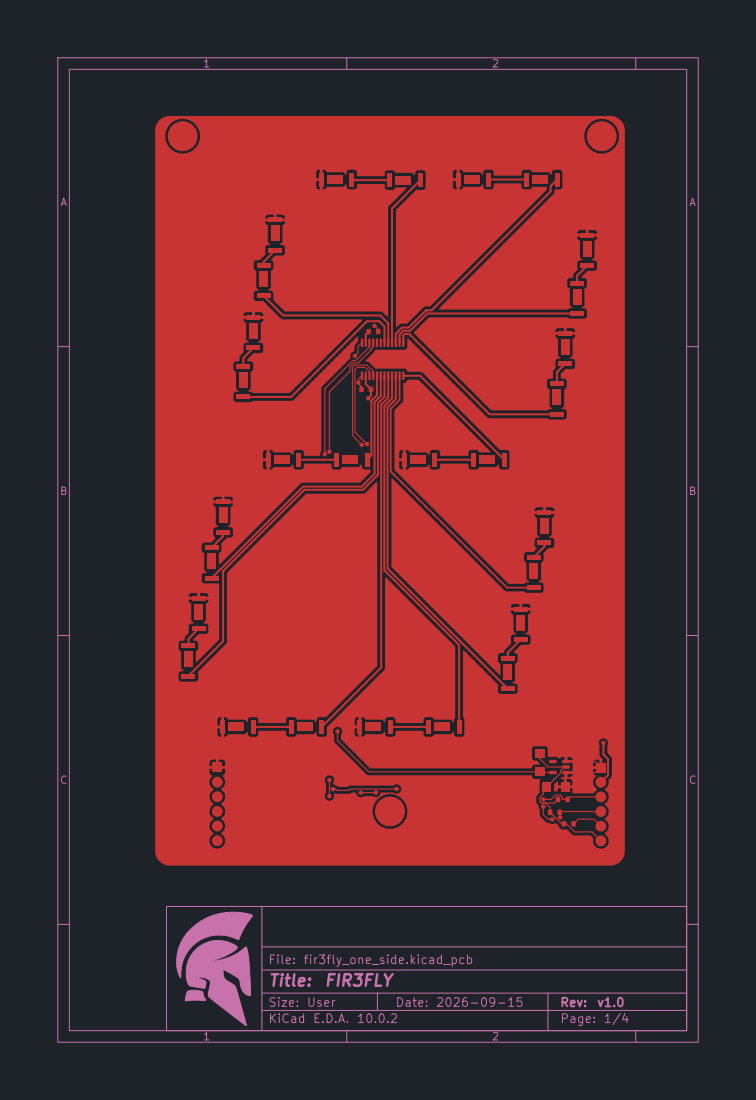
[picture p35: page 1]

Size: User | Rev: v1.0
KiCad E.D.A. 10.0.2

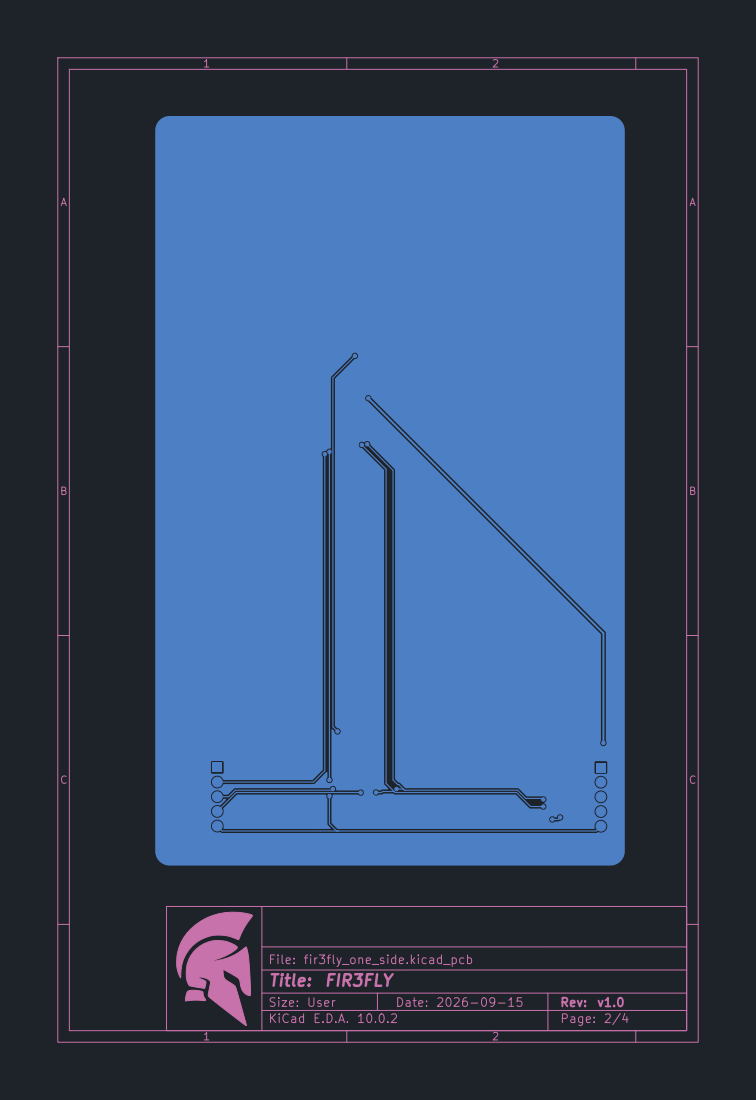
[picture p36: page 2]

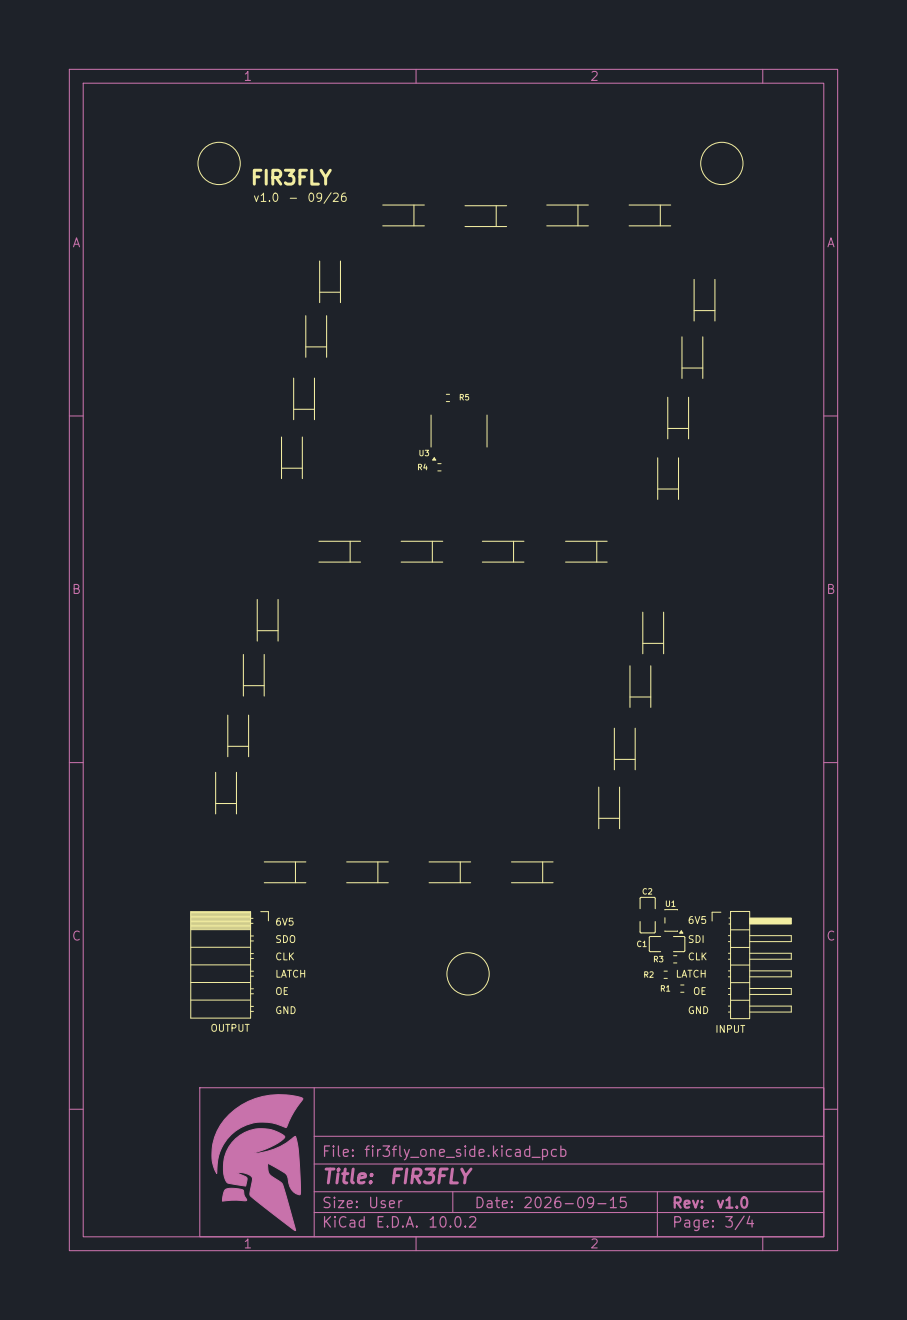
[picture p37: page 3]

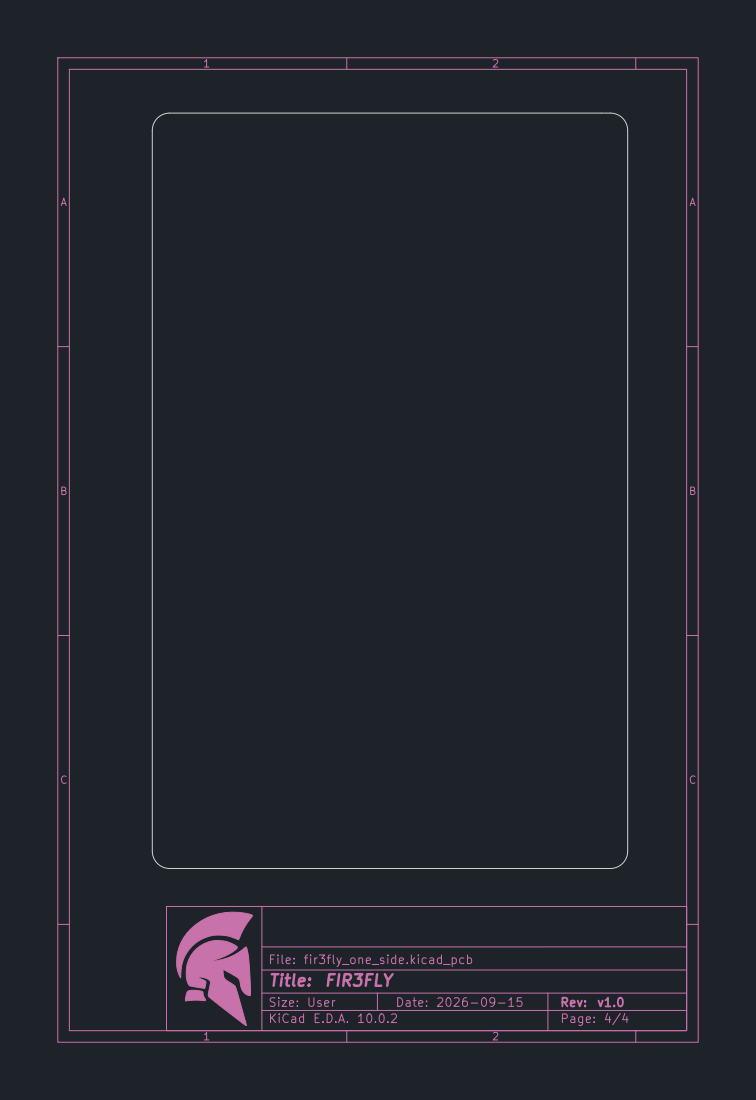
[picture p38: page 4]
