Catalysxt/fir3fly/fab/archive/v1/schematic_v1.1.pdf

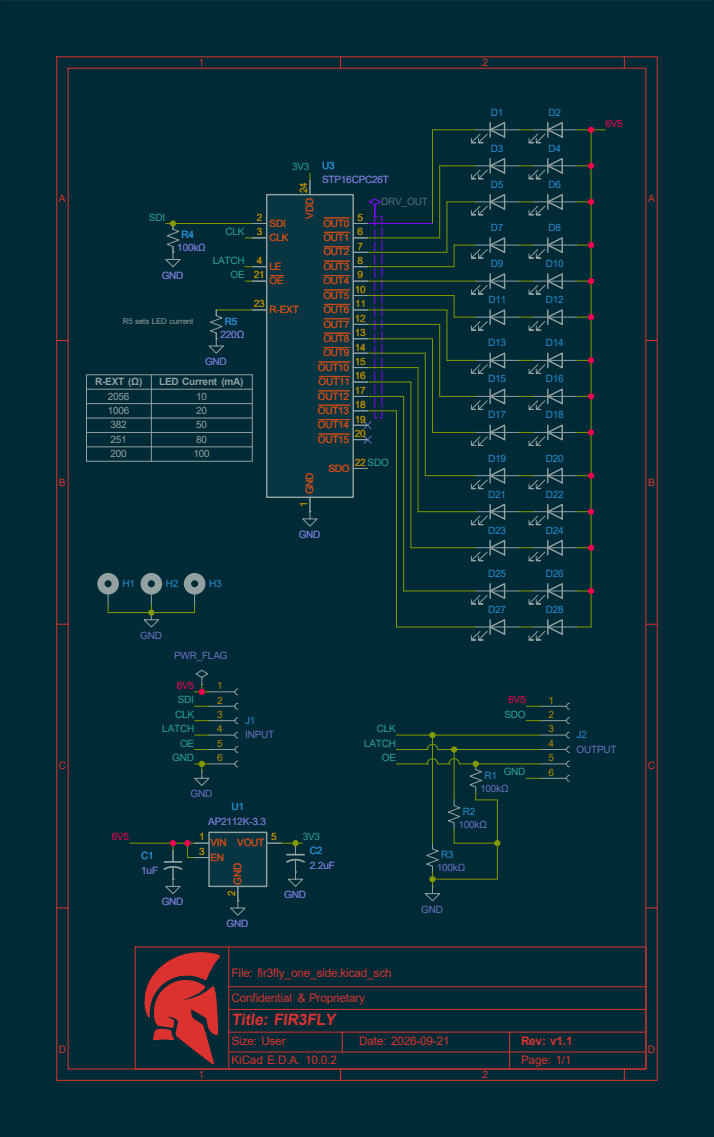
[picture p39: page 1]

1006 | 20
382 | 50
251 | 80
