Catalysxt/fir3fly/kicad_project-files/v2/v2.kicad_pcb

## KiCad design kicad_project-files/v2/v2.kicad_pcb (2026-10-04)

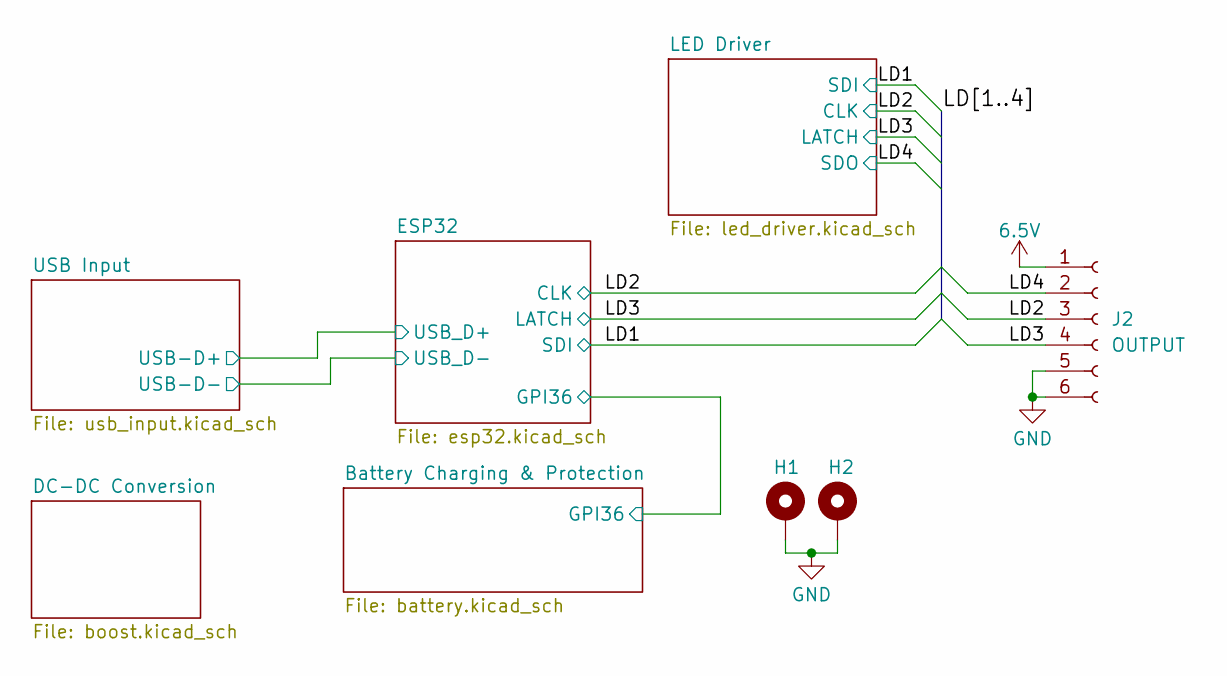
[picture p40: schematic v2.kicad_sch, FIR3FLY]

Parts:
H1, H2: MountingHole_Pad; MountingHole_2.5mm_Pad
J2: OUTPUT; PinSocket_1x06_P2.54mm_Horizontal

Connections:
/6.5V: J2.1
/LD2: J2.3; also elsewhere on the board
/LD3: J2.4; also elsewhere on the board
/LD4: J2.2; also elsewhere on the board
GND: H1.1 (1_1), H2.1 (1_1), J2.5, J2.6; also elsewhere on the board

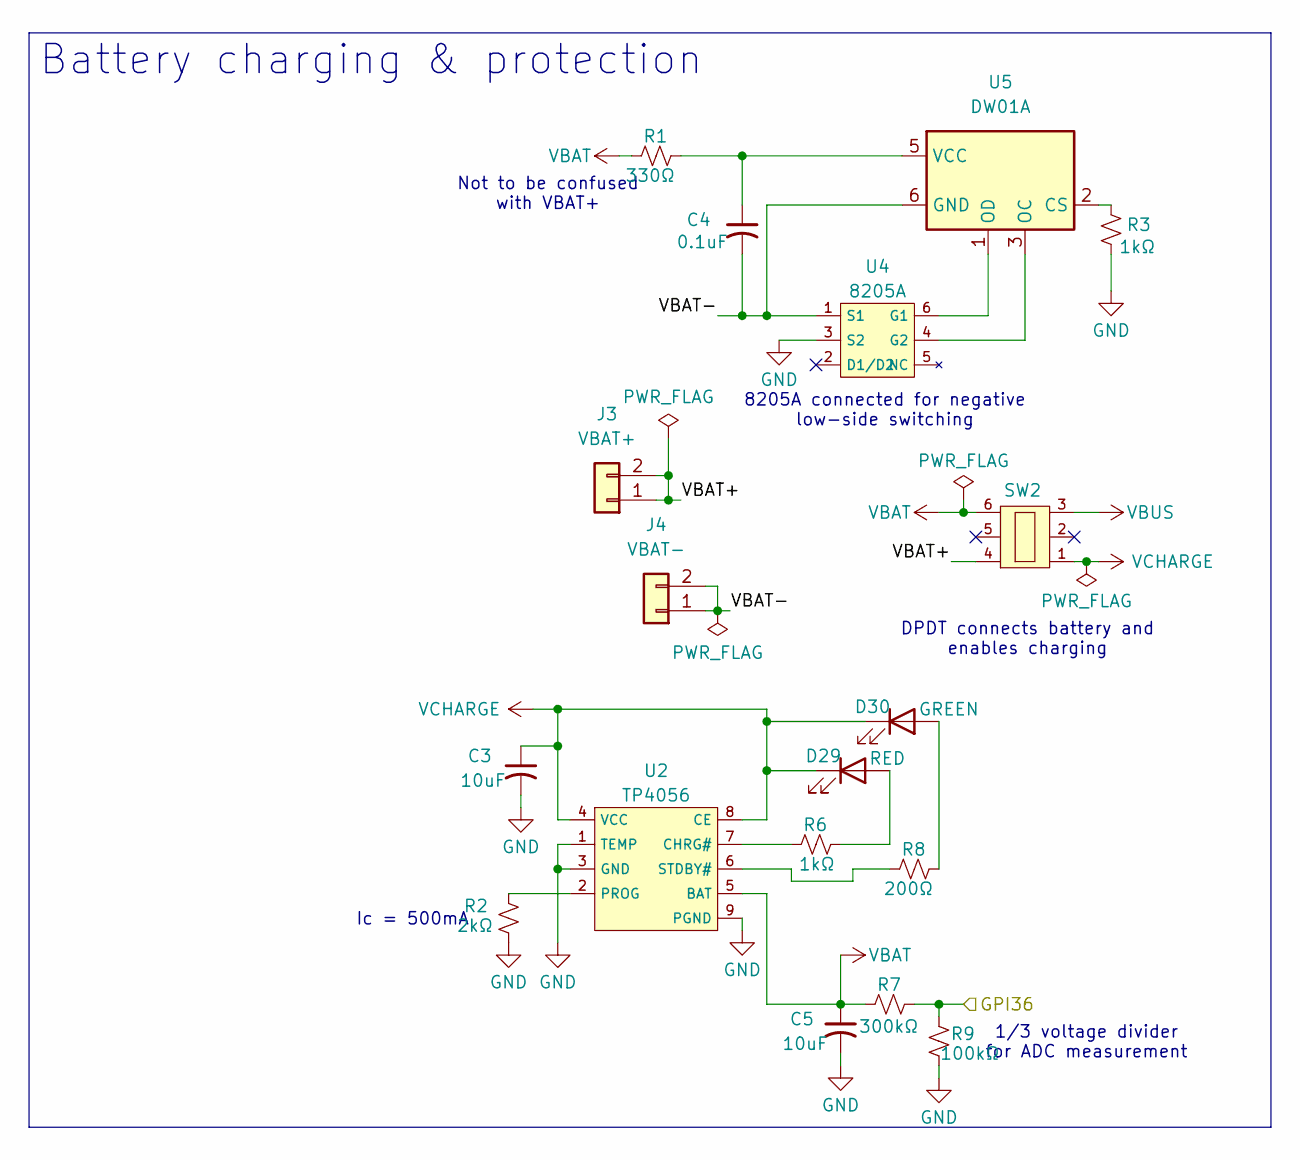
[picture p41: schematic battery.kicad_sch]

Parts:
C3, C5: 10uF; Taiyo Yuden TMK107BBJ106MA-T; Voltage Rating 25V; Part Type Basic; JLCPCB Part # C96446
C4: 0.1uF; C1206; Voltage Rating 50V; Part Type Basic; JLCPCB Part # C24497
D29: RED; LED_0805_Red; Part Type Basic; JLCPCB Part # C84256
D30: GREEN; LED_0805_Green; Part Type Extended; JLCPCB Part # C84260
J3: VBAT+; 18650 Battery Clip; Part Type Extended; JLCPCB Part # C2979182
J4: VBAT-; 18650 Battery Clip; Part Type Extended; JLCPCB Part # C2979182
R1: 330Ω; R_0603_1608Metric; Part Type Basic; JLCPCB Part # C23138
R2: 2kΩ; R_0603_1608Metric; Part Type Basic; JLCPCB Part # C22975
R3, R6: 1kΩ; R_0603_1608Metric; Part Type Basic; JLCPCB Part # C21190
R7: 300kΩ; R_0603_1608Metric; JLCPCB Part # C23024
R8: 200Ω; R_0603_1608Metric; Part Type Basic; JLCPCB Part # C8218
R9: 100kΩ; R_0603_1608Metric; Part Type Basic; JLCPCB Part # C25803
SW2: DPDT SW; Part Type Extended; JLCPCB Part # C22470282
U2: TP4056; ESOP-8_L4.9-W3.9-P1.27-LS6.0-BL-EP; Part Type Extended; LCSC Part # C5311018
U4: 8205A; 8205A_SOT-23-6_L2.9-W1.6-P0.95-LS2.8-BR; JLCPCB Part # C2762931
U5: DW01A; SOT-23-6

Connections:
/Battery Charging & Protection/GPI36: R7.2, R9.2; also elsewhere on the board
/Battery Charging & Protection/VBAT+: J3.1, J3.2, SW2.4
/Battery Charging & Protection/VBAT-: C4.2, J4.1, J4.2, U4.1 (S1), U5.6 (GND)
GND: C3.2, C5.2, R2.1, R3.2, R9.1, U2.1 (TEMP), U2.3 (GND), U2.9 (PGND), U4.3 (S2); also elsewhere on the board
unnamed: D29.2 (A), R6.2
unnamed: D30.2 (A), R8.2
unnamed: R6.1, U2.7 (CHRG#)
unnamed: R2.2, U2.2 (PROG)
unnamed: R8.1, U2.6 (STDBY#)
unnamed: U4.6 (G1), U5.1 (OD)
unnamed: U4.4 (G2), U5.3 (OC)
unnamed: R3.1, U5.2 (CS)
unnamed: C4.1, R1.2, U5.5 (VCC)
VBAT: C5.1, R1.1, R7.1, SW2.6, U2.5 (BAT); also elsewhere on the board
VBUS: SW2.3; also elsewhere on the board
VCHARGE: C3.1, D29.1 (K), D30.1 (K), SW2.1, U2.4 (VCC), U2.8 (CE)

Notes on the sheet:
8205A connected for negative low-side switching
DPDT connects battery and enables charging
Not to be confused with VBAT+
Ic = 500mA
1/3 voltage divider for ADC measurement
Battery charging & protection

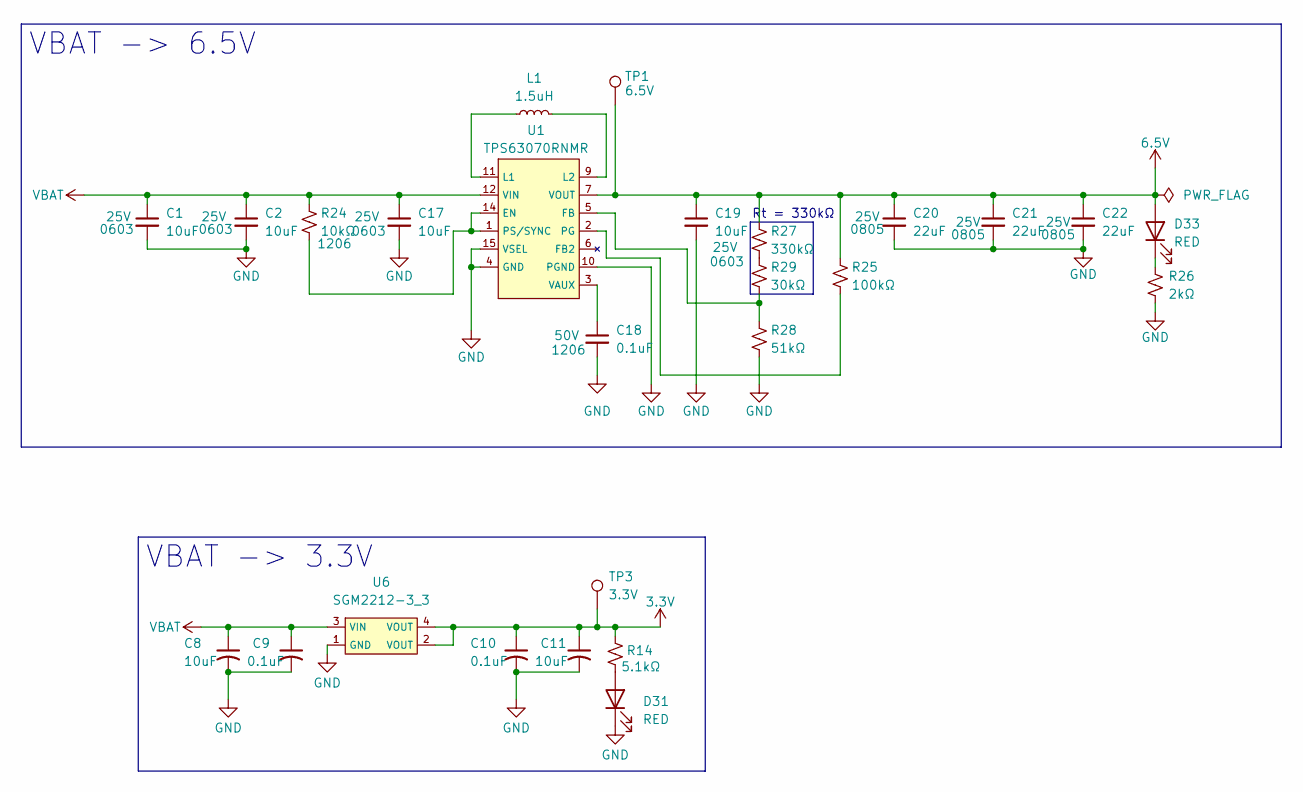
[picture p42: schematic boost.kicad_sch]

Parts:
C1, C2, C8, C11, C17, C19: 10uF; Taiyo Yuden TMK107BBJ106MA-T; Voltage Rating 25V; Part Type Basic; JLCPCB Part # C96446
C9, C10, C18: 0.1uF; C1206; Voltage Rating 50V; Part Type Basic; JLCPCB Part # C24497
C20, C21, C22: 22uF; C0805; Voltage Rating 25V; JLCPCB Part # C45783
D31, D33: RED; LED_0805_Red; Part Type Basic; JLCPCB Part # C84256
L1: 1.5uH; Coilcraft XFL4020-152MEC; Part Type Extended; JLCPCB Part # C3033018
R14: 5.1kΩ; R_0603_1608Metric; Part Type Basic; JLCPCB Part # C23186
R24: 10kΩ; R_0603_1608Metric; JLCPCB Part # C25804
R25: 100kΩ; R_0603_1608Metric; Part Type Basic; JLCPCB Part # C25803
R26: 2kΩ; R_0603_1608Metric
R27: 330kΩ; 0603_SMD; Part Type Basic; JLCPCB Part # C23137
R28: 51kΩ; 0603_SMD; Part Type Basic; JLCPCB Part # C23196
R29: 30kΩ; 0603_SMD; Part Type Basic; JLCPCB Part # C22984
TP1: 6.5V; TestPoint_Pad_D1.5mm
TP3: 3.3V; TestPoint_Pad_D1.5mm
U1: TPS63070RNMR; TPS63070; LCSC C109322
U6: SGM2212-3_3; SOT-223-3

Connections:
3.3V: C10.1, C11.1, R14.1, TP3.1 (1_1), U6.2 (VOUT), U6.4 (VOUT); also elsewhere on the board
6.5V: C19.1, C20.1, C21.1, C22.1, D33.2 (A), R25.1, R27.1, TP1.1 (1_1), U1.7 (VOUT); also elsewhere on the board
GND: C1.2, C2.2, C8.2, C9.2, C10.2, C11.2, C17.2, C18.2, C19.2, C20.2, C21.2, C22.2, D31.1 (K), R26.2, R28.2, U1.4 (GND), U1.10 (PGND), U1.15 (VSEL), U6.1 (GND); also elsewhere on the board
unnamed: D31.2 (A), R14.2
unnamed: D33.1 (K), R26.1
unnamed: R27.2, R29.1
unnamed: R24.2, U1.1 (PS/SYNC), U1.14 (EN)
unnamed: R28.1, R29.2, U1.5 (FB)
unnamed: L1.1, U1.11 (L1)
unnamed: L1.2, U1.9 (L2)
unnamed: R25.2, U1.2 (PG)
unnamed: C18.1, U1.3 (VAUX)
VBAT: C1.1, C2.1, C8.1, C9.1, C17.1, R24.1, U1.12 (VIN), U6.3 (VIN); also elsewhere on the board

Notes on the sheet:
Rt = 330kΩ
VBAT -> 3.3V
VBAT -> 6.5V

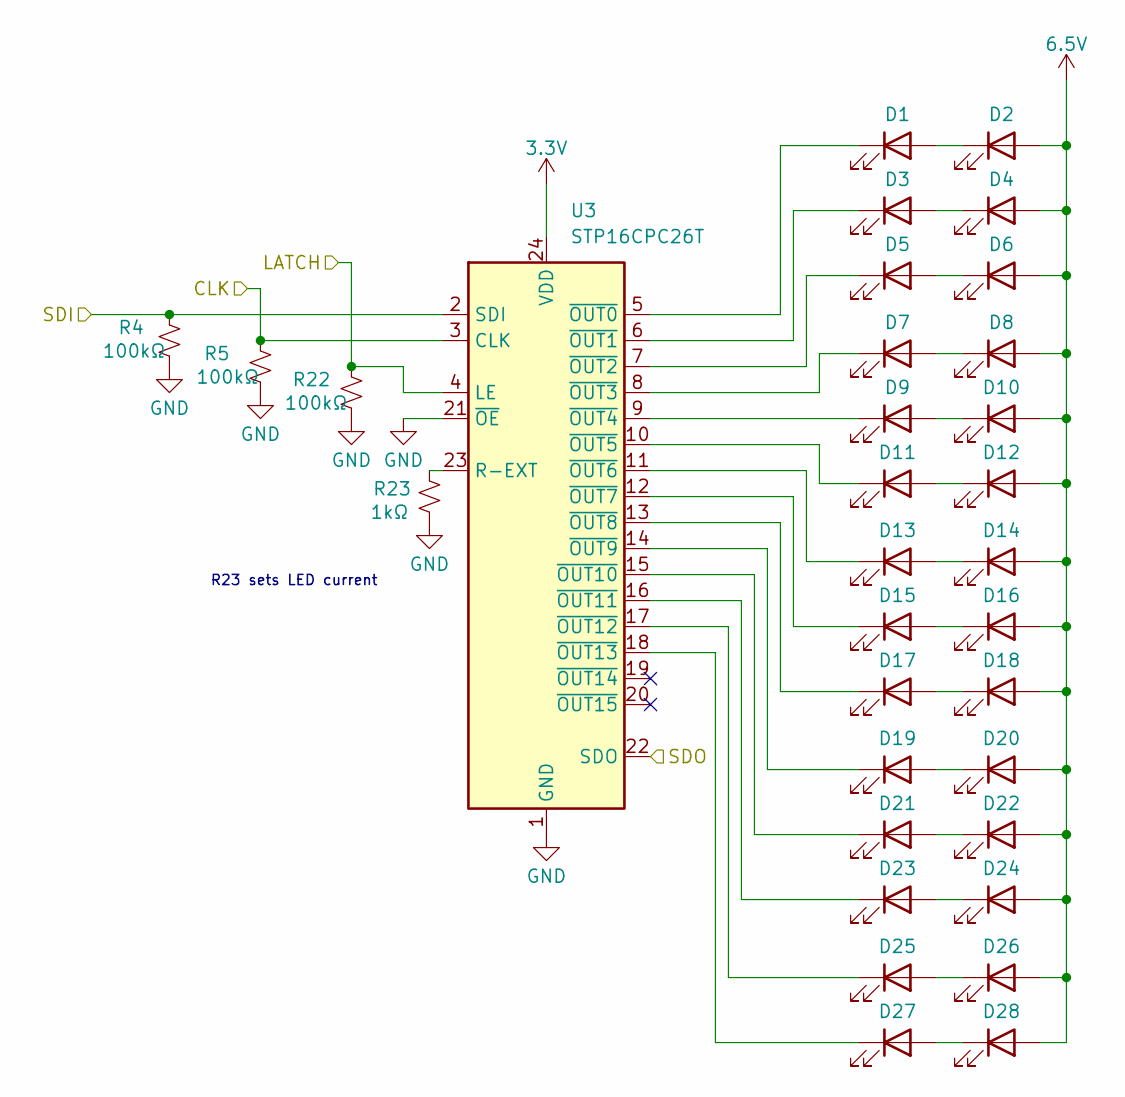
[picture p43: schematic led_driver.kicad_sch]

Parts:
D1: LED; LED-SMD_3P-L5.7-W3.0-RD; Part Type Extended; JLCPCB Part # C210347
D2, D3, D4, D5, D6, D7, D8, D9, D10, D11, D12, D13, D14, D15, D16, D17, D18, D19, D20, D21, D22, D23, D24, D25, D26, D27, D28: LED; LED-SMD_3P-L5.7-W3.0-RD; JLCPCB Part # C210347
R4, R5, R22: 100kΩ; R_0603_1608Metric; Part Type Basic; JLCPCB Part # C25803
R23: 1kΩ; R_0603_1608Metric; Part Type Basic; JLCPCB Part # C21190
U3: STP16CPC26T; TSSOP-24_4.4x7.8mm_P0.65mm

Connections:
3.3V: U3.24 (VDD); also elsewhere on the board
6.5V: D2.2 (A), D4.2 (A), D6.2 (A), D8.2 (A), D10.2 (A), D12.2 (A), D14.2 (A), D16.2 (A), D18.2 (A), D20.2 (A), D22.2 (A), D24.2 (A), D26.2 (A), D28.2 (A); also elsewhere on the board
/LD1: R4.1, U3.2 (SDI); also elsewhere on the board
/LD2: R5.1, U3.3 (CLK); also elsewhere on the board
/LD3: R22.1, U3.4 (LE); also elsewhere on the board
/LD4: U3.22 (SDO); also elsewhere on the board
GND: R4.2, R5.2, R22.2, R23.2, U3.1 (GND), U3.21 (~OE); also elsewhere on the board
unnamed: D1.2 (A), D2.1 (K)
unnamed: D1.1 (K), U3.5 (~OUT0)
unnamed: D3.2 (A), D4.1 (K)
unnamed: D3.1 (K), U3.6 (~OUT1)
unnamed: D5.2 (A), D6.1 (K)
unnamed: D5.1 (K), U3.7 (~OUT2)
unnamed: D7.2 (A), D8.1 (K)
unnamed: D7.1 (K), U3.8 (~OUT3)
unnamed: D9.1 (K), U3.9 (~OUT4)
unnamed: D9.2 (A), D10.1 (K)
unnamed: D11.2 (A), D12.1 (K)
unnamed: D11.1 (K), U3.10 (~OUT5)
unnamed: D13.2 (A), D14.1 (K)
unnamed: D13.1 (K), U3.11 (~OUT6)
unnamed: D15.2 (A), D16.1 (K)
unnamed: D15.1 (K), U3.12 (~OUT7)
unnamed: D17.2 (A), D18.1 (K)
unnamed: D17.1 (K), U3.13 (~OUT8)
unnamed: D19.2 (A), D20.1 (K)
unnamed: D19.1 (K), U3.14 (~OUT9)
unnamed: D21.2 (A), D22.1 (K)
unnamed: D21.1 (K), U3.15 (~OUT10)
unnamed: D23.2 (A), D24.1 (K)
unnamed: D23.1 (K), U3.16 (~OUT11)
unnamed: D25.2 (A), D26.1 (K)
unnamed: D25.1 (K), U3.17 (~OUT12)
unnamed: D27.2 (A), D28.1 (K)
unnamed: D27.1 (K), U3.18 (~OUT13)
unnamed: R23.1, U3.23 (R-EXT)

Notes on the sheet:
R23 sets LED current

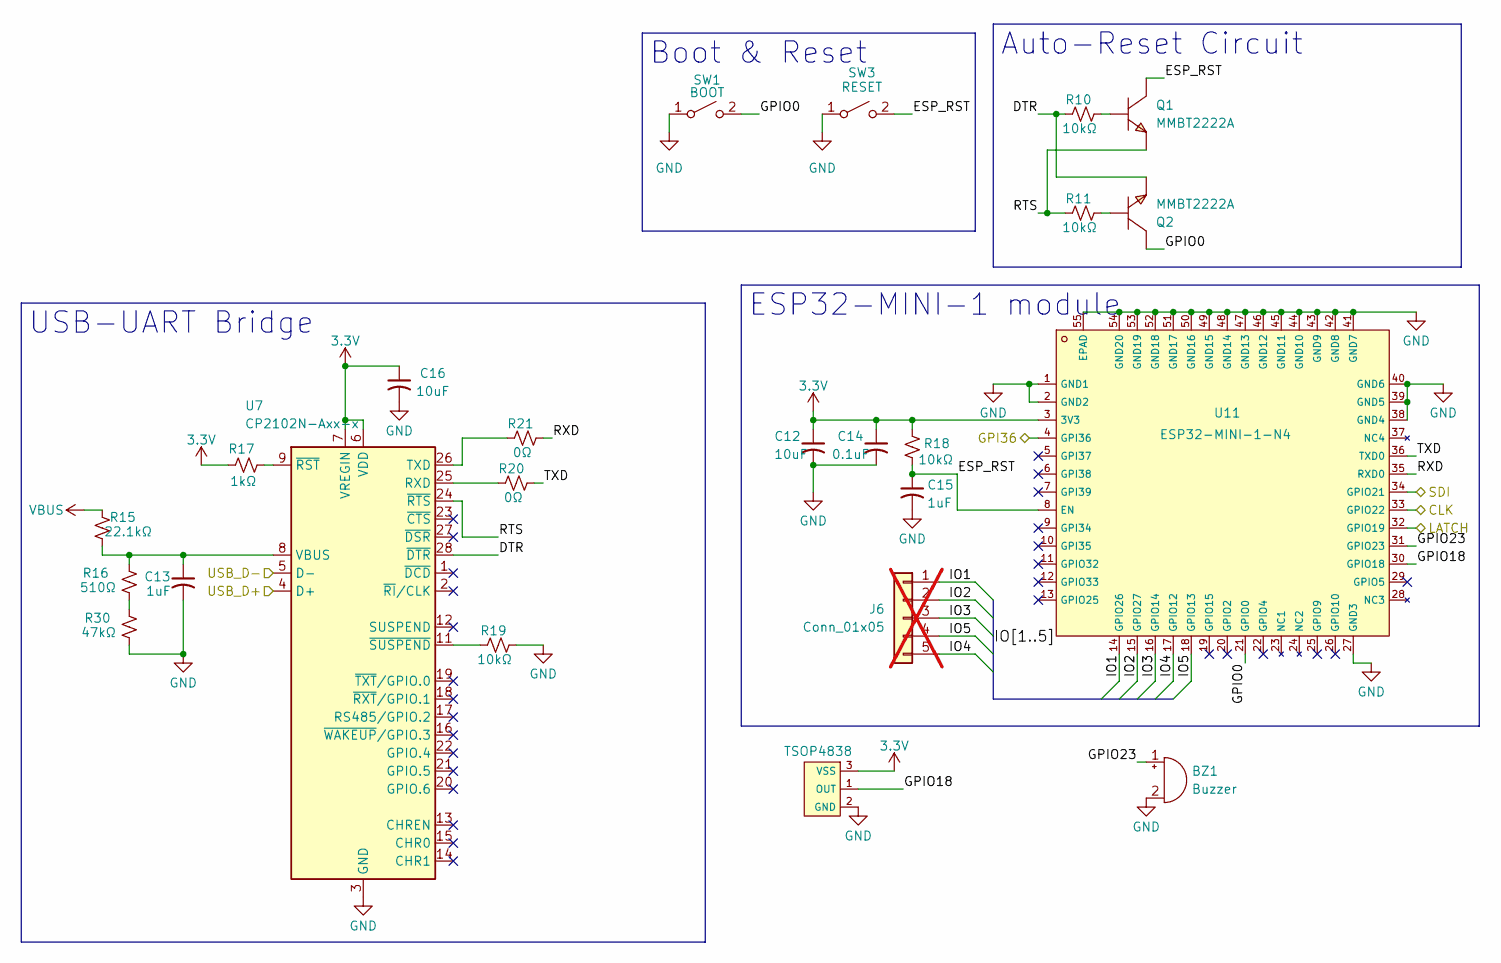
[picture p44: schematic esp32.kicad_sch]

Parts:
BZ1: Buzzer; BUZ-SMD_L9.6-W9.6-LS10.0-R; JLCPCB Part # C96127
C12, C16: 10uF; Taiyo Yuden TMK107BBJ106MA-T; Voltage Rating 25V; Part Type Basic; JLCPCB Part # C96446
C13, C15: 1uF; C1206; Voltage Rating 50V; Part Type Basic; JLCPCB Part # C1848
C14: 0.1uF; C1206; Voltage Rating 50V; Part Type Basic; JLCPCB Part # C24497
CGQ1: TSOP4838; JLCPCB Part # C124647
J6: Conn_01x05; PinSocket_1x05_P2.54mm_Vertical; not fitted
Q1, Q2: MMBT2222A; SOT-23-3_L2.9-W1.3-P1.90-LS2.4-BR; Part Type Basic; JLCPCB Part # C8512
R10, R11, R18: 10kΩ; R_0603_1608Metric; JLCPCB Part # C25804
R15: 22.1kΩ; R_0603_1608Metric; Part Type Basic; JLCPCB Part # C31850
R16: 510Ω; R_0603_1608Metric; Part Type Basic; JLCPCB Part # C23193
R17: 1kΩ; R_0603_1608Metric; Part Type Basic; JLCPCB Part # C21190
R19: 10kΩ; R_0603_1608Metric
R20, R21: 0Ω; 0603_SMD; Voltage Rating 0603; JLCPCB Part # C21189
R30: 47kΩ; R_0603_1608Metric; JLCPCB Part # C25819
SW1: BOOT; SW-SMD_L3.9-W3.0-P4.45; JLCPCB Part # C720477
SW3: RESET; SW-SMD_L3.9-W3.0-P4.45; JLCPCB Part # C720477
U7: CP2102N-Axx-x; QFN-28-1EP_5x5mm_P0.5mm_EP3.35x3.35mm
U11: ESP32-MINI-1-N4; ESP32-MINI-1 Module

Connections:
3.3V: C12.1, C14.1, C16.1, CGQ1.3 (VSS), R17.1, R18.1, U7.6 (VDD), U7.7 (VREGIN), U11.3 (3V3); also elsewhere on the board
/Battery Charging & Protection/GPI36: U11.4 (GPI36); also elsewhere on the board
/ESP32/DTR: Q2.2 (E), R10.1, U7.28 (~DTR)
/ESP32/ESP_RST: C15.1, Q1.3 (C), R18.2, SW3.2 (B), U11.8 (EN)
/ESP32/GPIO0: Q2.3 (C), SW1.2 (B), U11.21 (GPIO0)
/ESP32/GPIO18: CGQ1.1 (OUT), U11.30 (GPIO18)
/ESP32/GPIO23: BZ1.1 (+), U11.31 (GPIO23)
/ESP32/IO1: J6.1, U11.14 (GPIO26)
/ESP32/IO2: J6.2, U11.15 (GPIO27)
/ESP32/IO3: J6.3, U11.16 (GPIO14)
/ESP32/IO4: J6.5, U11.17 (GPIO12)
/ESP32/IO5: J6.4, U11.18 (GPIO13)
/ESP32/RTS: Q1.2 (E), R11.1, U7.24 (~RTS)
/ESP32/RXD: R21.2, U11.35 (RXD0)
/ESP32/TXD: R20.2, U11.36 (TXD0)
/ESP32/USB_D+: U7.4 (D+); also elsewhere on the board
/ESP32/USB_D-: U7.5 (D-); also elsewhere on the board
/LD1: U11.34 (GPIO21); also elsewhere on the board
/LD2: U11.33 (GPIO22); also elsewhere on the board
/LD3: U11.32 (GPIO19); also elsewhere on the board
GND: BZ1.2 (-), C12.2, C13.2, C14.2, C15.2, C16.2, CGQ1.2 (GND), R19.2, R30.1, SW1.1 (A), SW3.1 (A), U7.3 (GND), U7.29 (GND), U11.1 (GND1), U11.2 (GND2), U11.27 (GND3), U11.38 (GND4), U11.39 (GND5), U11.40 (GND6), U11.41 (GND7), U11.42 (GND8), U11.43 (GND9), U11.44 (GND10), U11.45 (GND11), U11.46 (GND12), U11.47 (GND13), U11.48 (GND14), U11.49 (GND15), U11.50 (GND16), U11.51 (GND17), U11.52 (GND18), U11.53 (GND19), U11.54 (GND20), U11.55 (EPAD); also elsewhere on the board
unnamed: Q1.1 (B), R10.2
unnamed: Q2.1 (B), R11.2
unnamed: R16.1, R30.2
unnamed: R20.1, U7.25 (RXD)
unnamed: R21.1, U7.26 (TXD)
unnamed: C13.1, R15.1, R16.2, U7.8 (VBUS)
unnamed: R17.2, U7.9 (~RST)
unnamed: R19.1, U7.11 (~SUSPEND)
VBUS: R15.2; also elsewhere on the board

Notes on the sheet:
Auto-Reset Circuit
ESP32-MINI-1 module
USB-UART Bridge
Boot & Reset

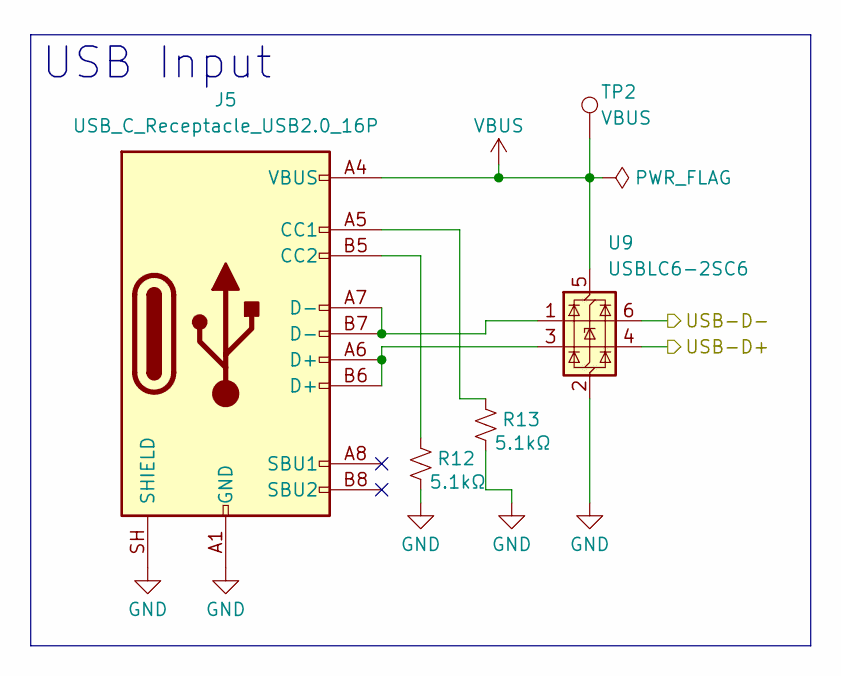
[picture p45: schematic usb_input.kicad_sch]

Parts:
J5: USB_C_Receptacle_USB2.0_16P; USB_C_Receptacle_GCT_USB4105-xx-A_16P_TopMnt_Horizontal
R12, R13: 5.1kΩ; R_0603_1608Metric; Part Type Basic; JLCPCB Part # C23186
TP2: VBUS; TestPoint_Pad_D1.5mm
U9: USBLC6-2SC6; SOT-23-6; Part Type Extended; JLCPCB Part # C7519

Connections:
/ESP32/USB_D+: U9.4 (I/O2); also elsewhere on the board
/ESP32/USB_D-: U9.6 (I/O1); also elsewhere on the board
GND: J5.A1 (GND), J5.A12 (GND), J5.B1 (GND), J5.B12 (GND), J5.SH (SHIELD), R12.2, R13.2, U9.2 (GND); also elsewhere on the board
unnamed: J5.A5 (CC1), R13.1
unnamed: J5.B5 (CC2), R12.1
unnamed: J5.A6 (D+), J5.B6 (D+), U9.3 (I/O2)
unnamed: J5.A7 (D-), J5.B7 (D-), U9.1 (I/O1)
VBUS: J5.A4 (VBUS), J5.A9 (VBUS), J5.B4 (VBUS), J5.B9 (VBUS), TP2.1 (1_1), U9.5 (VBUS); also elsewhere on the board

Notes on the sheet:
USB Input

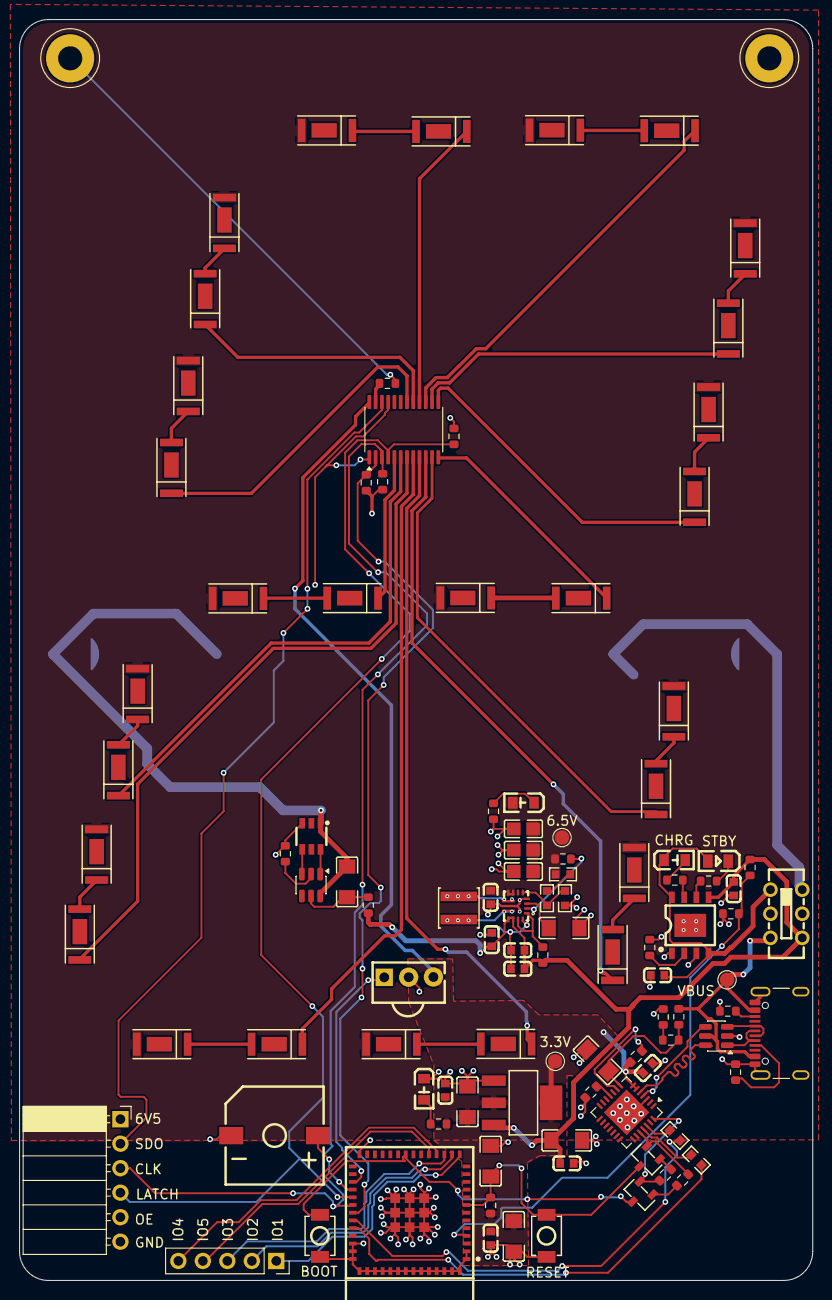
[picture p46: board v2.kicad_pcb from above]

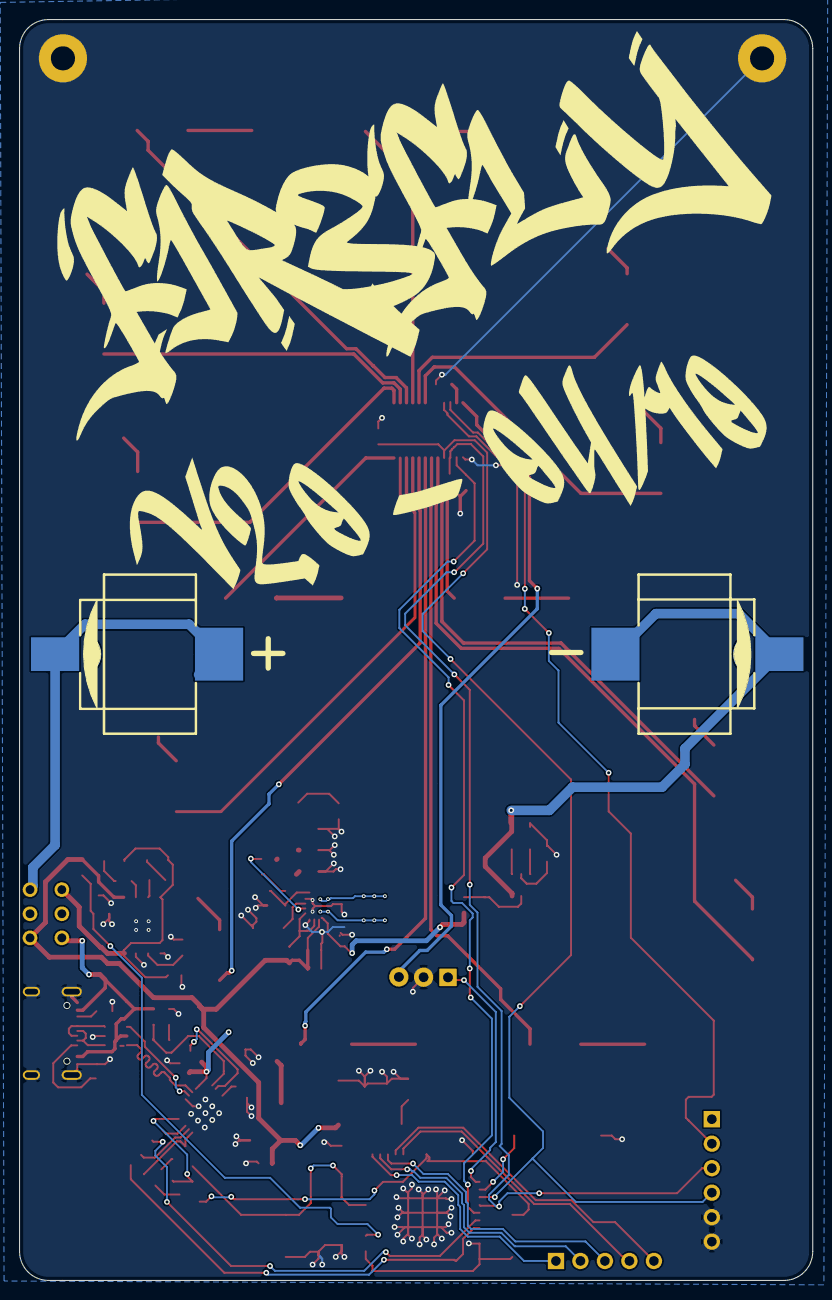
[picture p47: board v2.kicad_pcb from below]

Board: 2 copper layers, 82.2 x 130.8 mm, 109 parts (2 on the bottom side), 87 nets.
