Catalysxt/fir3fly/docs/enclosure/board_irl.png

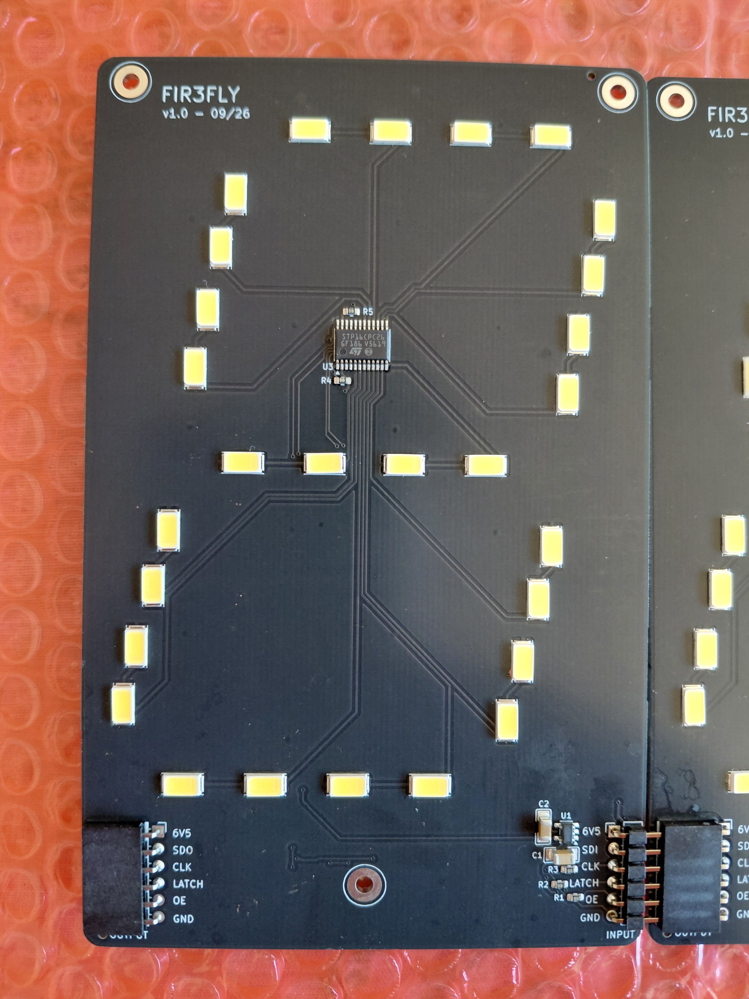
docs/enclosure/board_irl.png
